rei-okabayashi/denshi-tools/3d/ag03-stand/preview_full_bottom.png

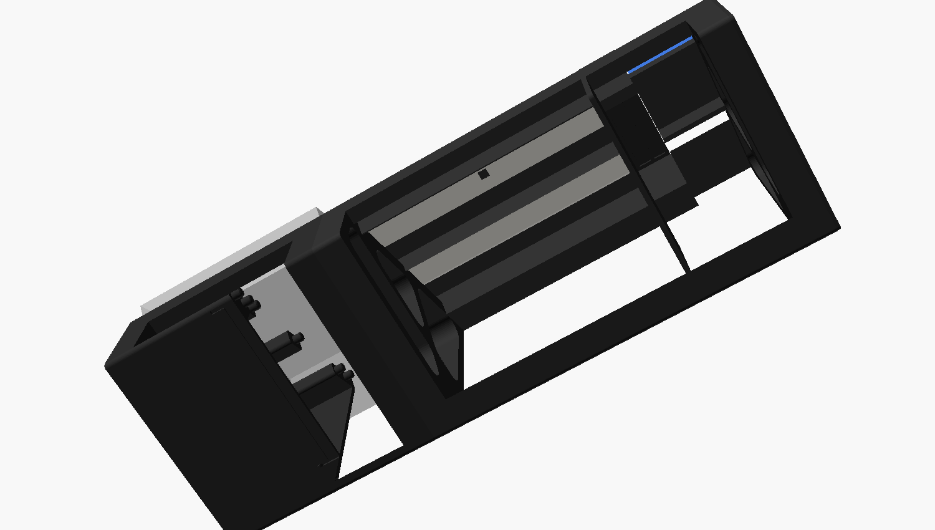
3d/ag03-stand/preview_full_bottom.png
