rei-okabayashi/denshi-tools/3d/ag03-stand/preview_iso.png

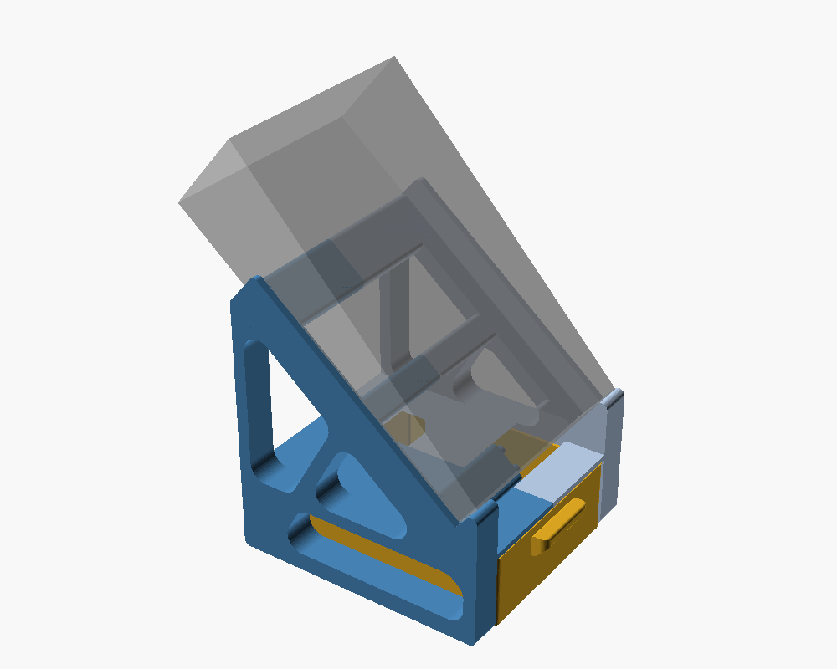
3d/ag03-stand/preview_iso.png
