rei-okabayashi/denshi-tools/3d/ag03-stand/preview_panel_ripple_side.png

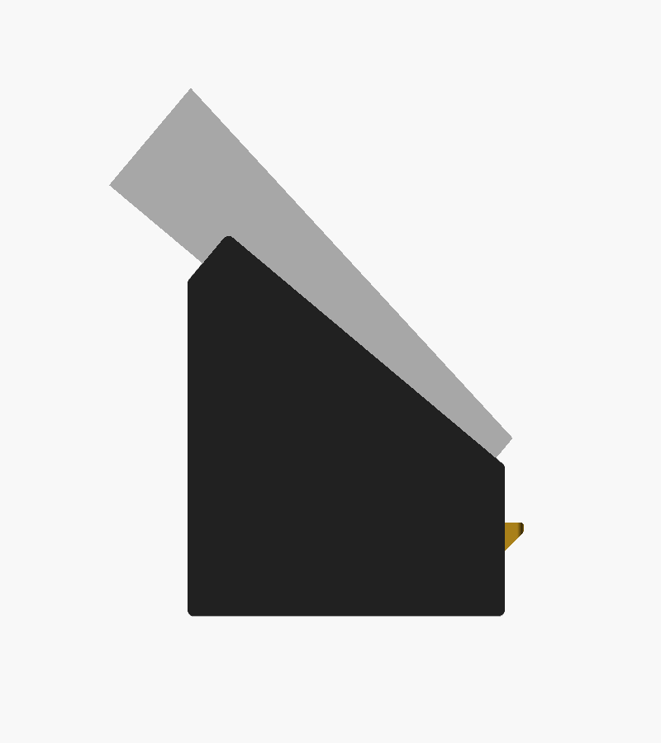
3d/ag03-stand/preview_panel_ripple_side.png
