rei-okabayashi/denshi-tools/3d/ag03-stand/side_panel_concepts.png

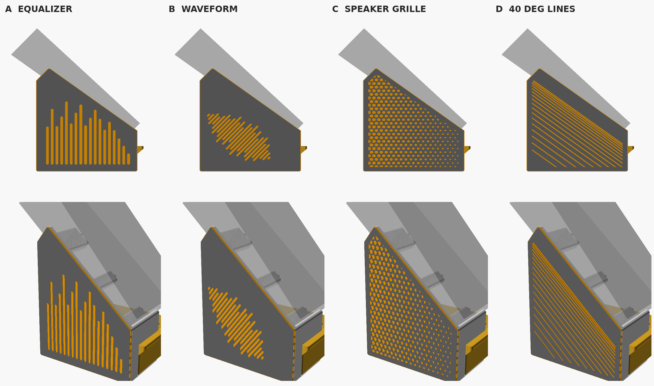
3d/ag03-stand/side_panel_concepts.png
