rei-okabayashi/denshi-tools/3d/ag03-stand/side_panel_concepts_fantasy.png

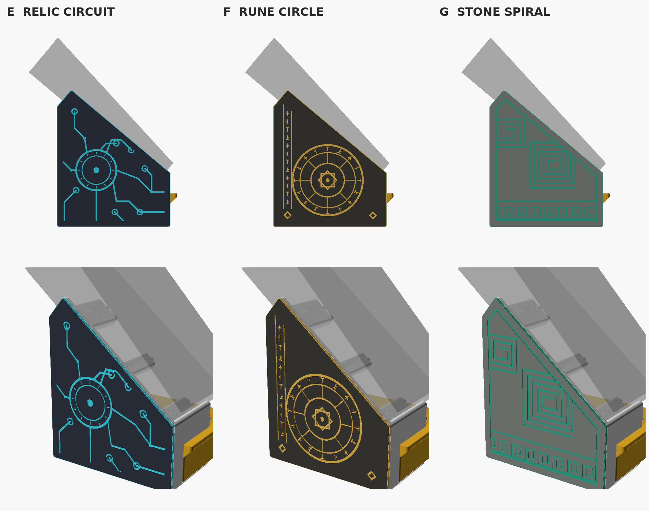
3d/ag03-stand/side_panel_concepts_fantasy.png
