rei-okabayashi/denshi-tools/3d/ag03-stand/ag03_stand_ext_lid.stl

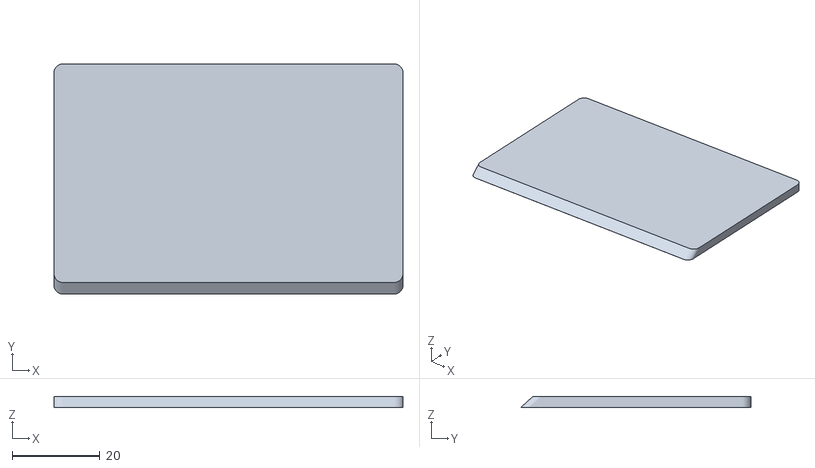
[picture p16: CAD file, 2026-11-06]
3d/ag03-stand/ag03_stand_ext_lid.stl
79.5 x 52.4 x 2.40
