rei-okabayashi/denshi-tools/3d/ag03-stand/viewer/stl/a_ext_p1.stl

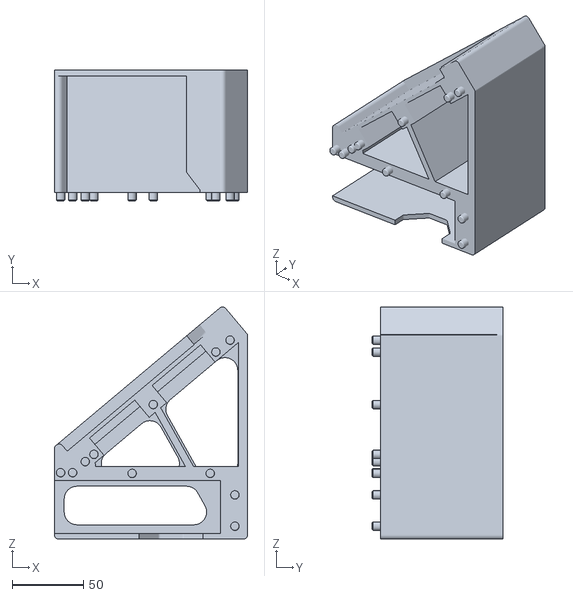
[picture p18: CAD file, 2026-11-06]
3d/ag03-stand/viewer/stl/a_ext_p1.stl
136.1 x 92.0 x 163.2
