rei-okabayashi/denshi-tools/3d/ag03-stand/ag03_stand_half_b.stl

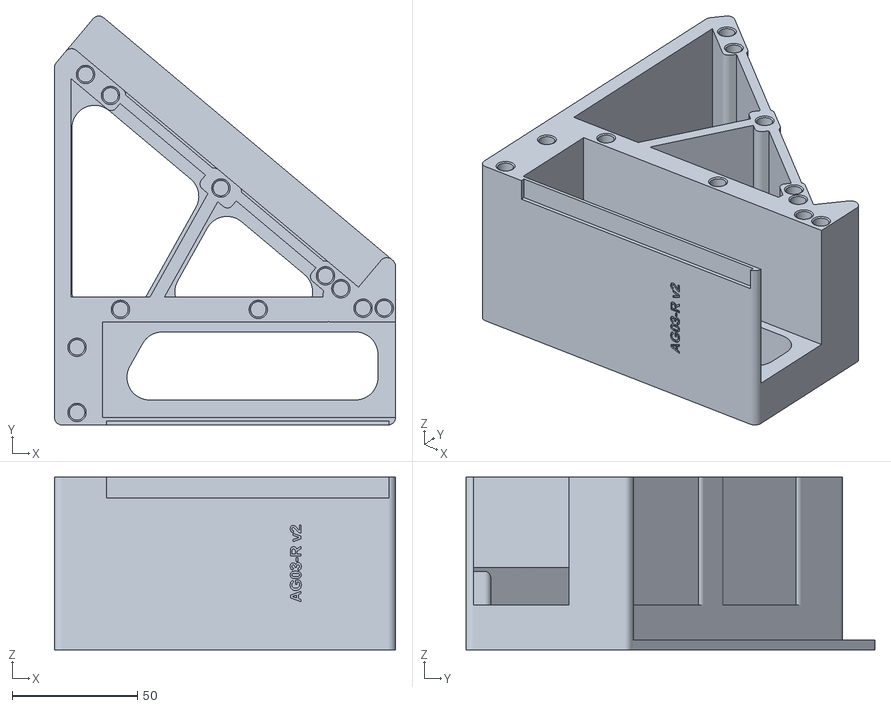
[picture p19: CAD file, 2026-11-06]
3d/ag03-stand/ag03_stand_half_b.stl
136.1 x 163.2 x 69.0
