rei-okabayashi/denshi-tools/3d/ag03-stand/viewer/stl/a_ag_a.stl

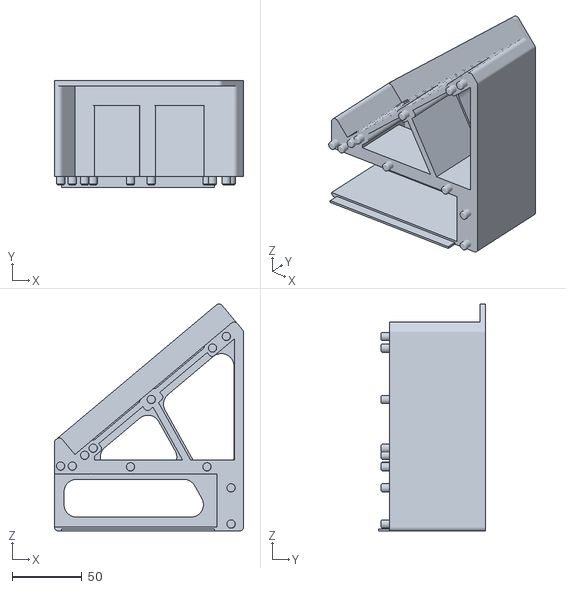
[picture p20: CAD file, 2026-11-06]
3d/ag03-stand/viewer/stl/a_ag_a.stl
136.1 x 77.0 x 163.2
