rei-okabayashi/denshi-tools/3d/ag03-stand/viewer/stl/a_ext_p2.stl

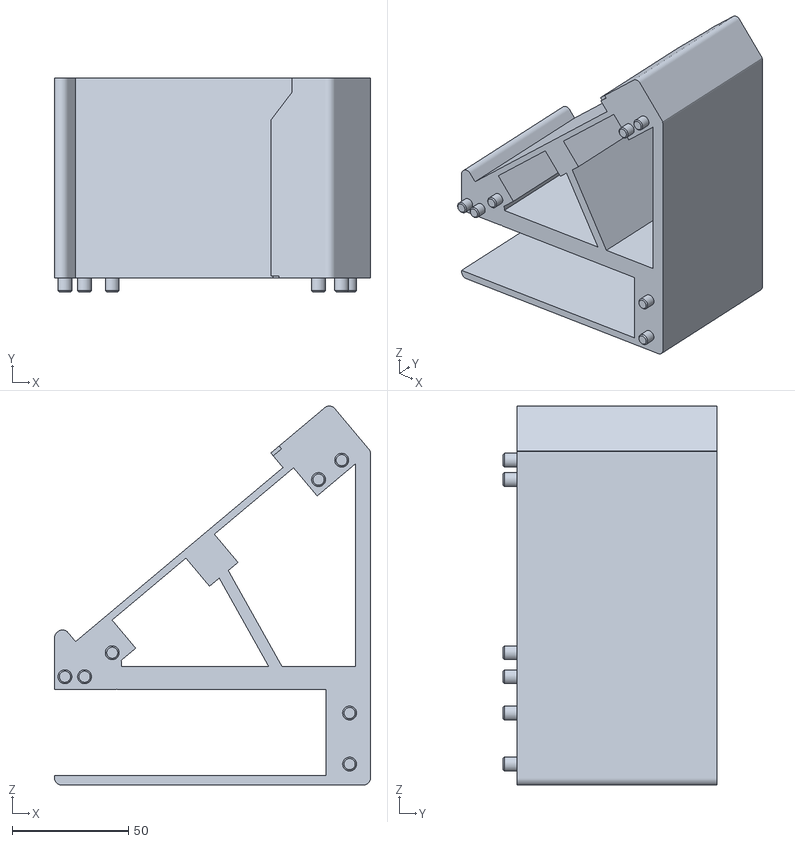
[picture p21: CAD file, 2026-11-06]
3d/ag03-stand/viewer/stl/a_ext_p2.stl
136.1 x 92.2 x 163.2
