rei-okabayashi/denshi-tools/3d/ag03-stand/ag03_stand_drawer.stl

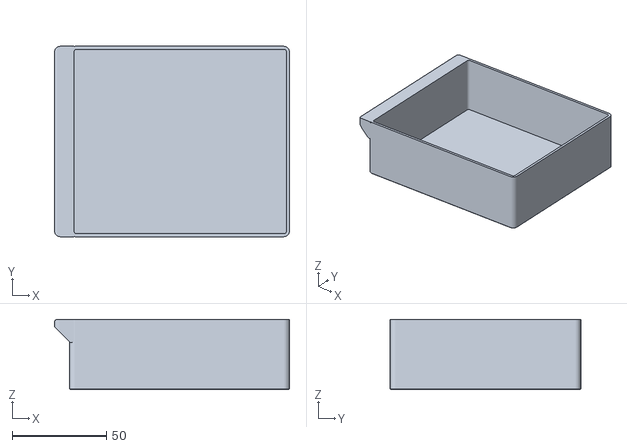
[picture p22: CAD file, 2026-11-06]
3d/ag03-stand/ag03_stand_drawer.stl
124.6 x 101.0 x 37.3
