rei-okabayashi/denshi-tools/3d/ag03-stand/viewer/stl/a_ext_cover.stl

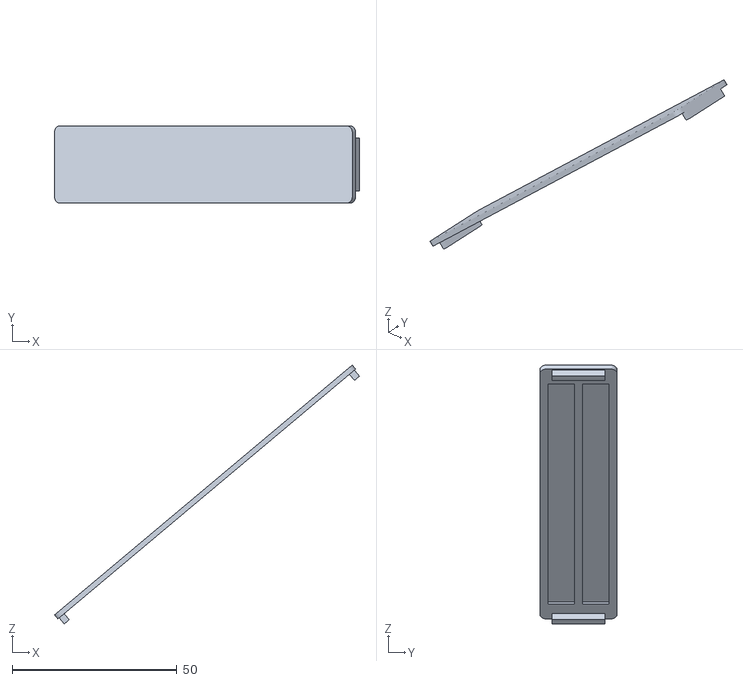
[picture p23: CAD file, 2026-11-06]
3d/ag03-stand/viewer/stl/a_ext_cover.stl
92.6 x 23.4 x 78.6
