rei-okabayashi/denshi-tools/3d/ag03-stand/ag03_stand_ext_p3.stl

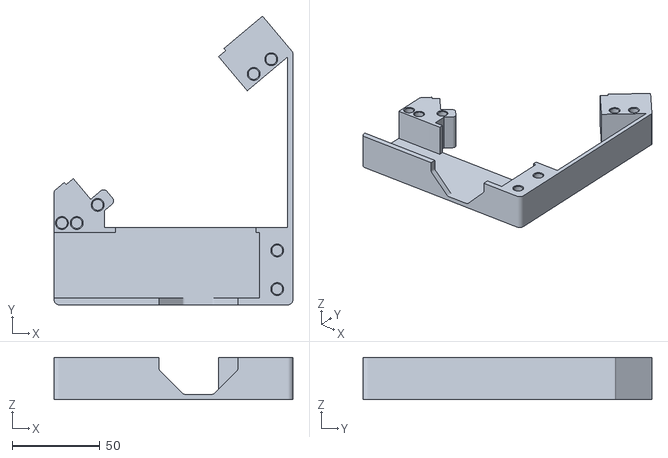
[picture p24: CAD file, 2026-11-05]
3d/ag03-stand/ag03_stand_ext_p3.stl
136.1 x 164.4 x 24.0
