rei-okabayashi/denshi-tools/3d/ag03-stand/ag03_stand_ext_cover.stl

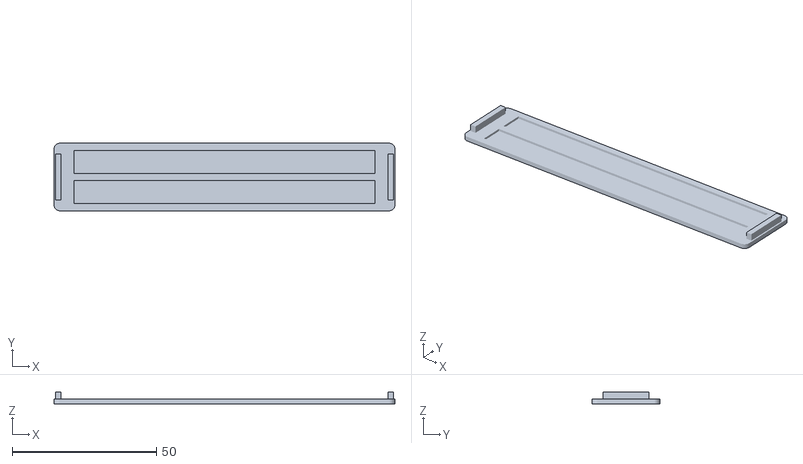
[picture p25: CAD file, 2026-11-05]
3d/ag03-stand/ag03_stand_ext_cover.stl
118.0 x 23.4 x 4.00
