rei-okabayashi/denshi-tools/3d/ag03-stand/viewer/stl/p_ext_p4.stl

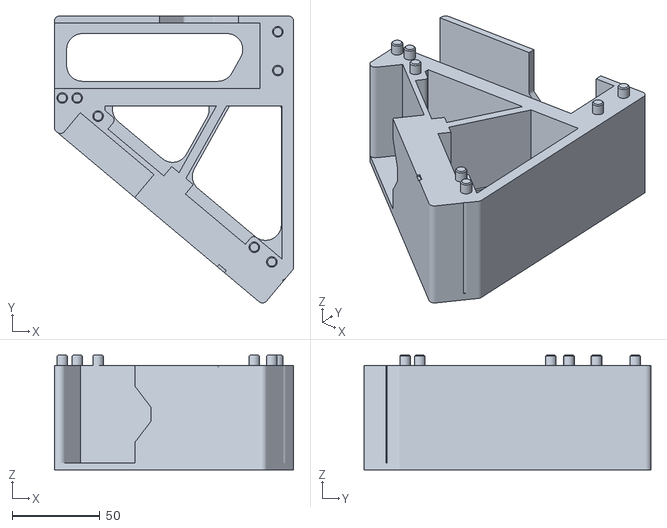
[picture p26: CAD file, 2026-11-06]
3d/ag03-stand/viewer/stl/p_ext_p4.stl
136.1 x 163.2 x 65.3
