rei-okabayashi/denshi-tools/3d/ag03-stand/ag03_stand_panel_a.stl

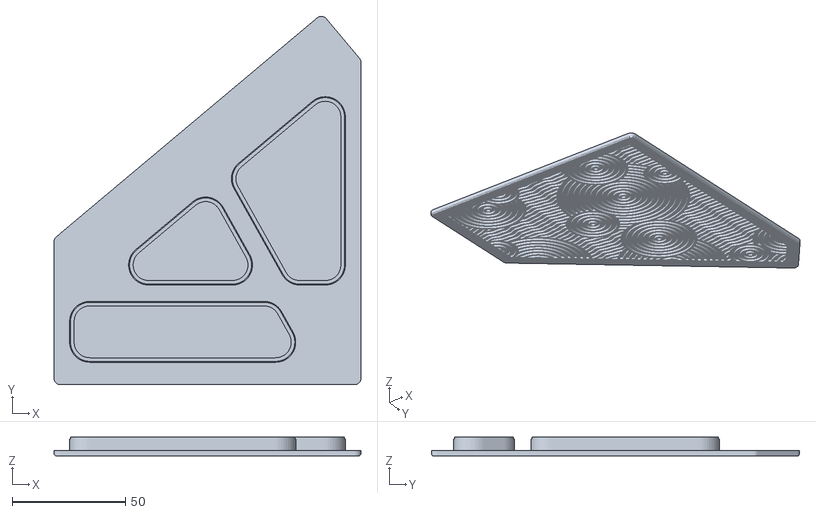
[picture p28: CAD file, 2026-11-04]
3d/ag03-stand/ag03_stand_panel_a.stl
135.7 x 162.8 x 8.39
