rei-okabayashi/denshi-tools/3d/ag03-stand/ag03_stand_fit_test.stl

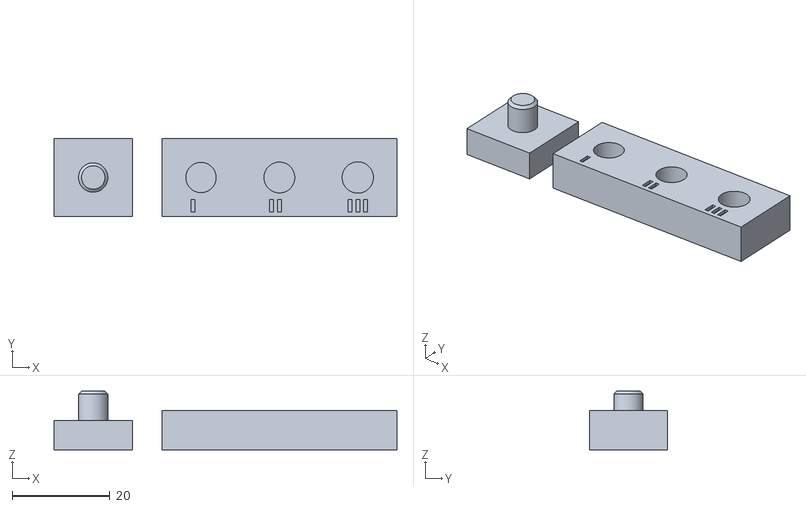
[picture p29: CAD file, 2026-11-03]
3d/ag03-stand/ag03_stand_fit_test.stl
70.0 x 16.0 x 12.0
