rei-okabayashi/denshi-tools/3d/ag03-stand/viewer/stl/a_ext_keys.stl

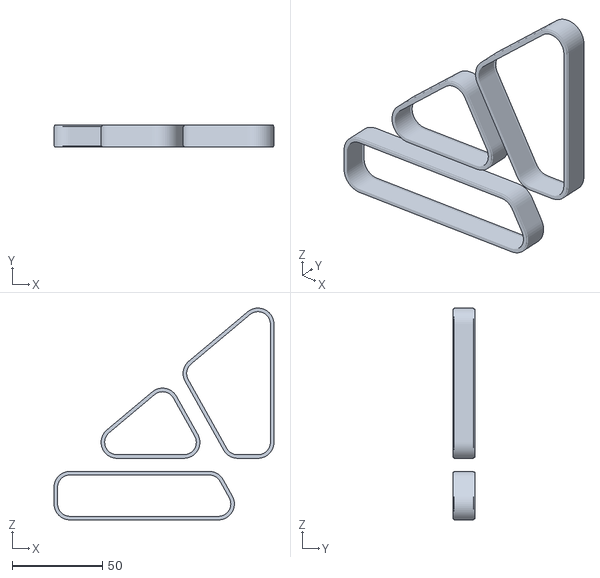
[picture p30: CAD file, 2026-11-05]
3d/ag03-stand/viewer/stl/a_ext_keys.stl
121.9 x 12.0 x 117.4
