rei-okabayashi/denshi-tools/3d/ag03-stand/viewer/stl/a_dev_m5.stl

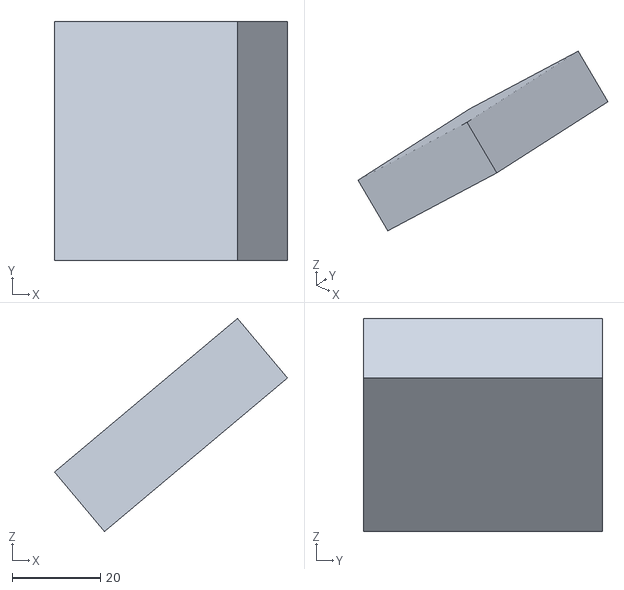
[picture p31: CAD file, 2026-11-05]
3d/ag03-stand/viewer/stl/a_dev_m5.stl
52.8 x 54.1 x 48.3
