rei-okabayashi/denshi-tools/3d/ag03-stand/ripple_pattern.scad

// 自動生成: tools/gen_ripple.py（手で編集しない）
module ripple_pattern2d() {
  polygon(points=[[-8.56,7.90],[-8.56,9.45],[-3.54,6.20],[-5.93,6.20]], paths=[[0, 1, 2, 3]]);
  polygon(points=[[0.00,8.70],[1.77,7.69],[2.63,6.20],[1.75,6.20],[-0.62,7.56],[-8.56,11.83],[-8.56,13.31]], paths=[[0, 1, 2, 3, 4, 5, 6]]);
  polygon(points=[[-3.60,16.21],[-1.81,15.46],[-1.02,15.04],[-0.56,13.31],[-2.34,14.28],[-4.03,14.99],[-8.56,16.47],[-8.56,17.84]], paths=[[0, 1, 2, 3, 4, 5, 6, 7]]);
  polygon(points=[[-5.74,22.65],[-3.64,22.28],[-2.39,21.94],[-1.80,21.73],[-1.77,20.33],[-2.75,20.69],[-3.95,21.01],[-5.90,21.36],[-8.56,21.65],[-8.56,22.95]], paths=[[0, 1, 2, 3, 4, 5, 6, 7, 8, 9]]);
  polygon(points=[[-6.76,27.73],[-4.68,27.46],[-2.68,27.07],[-1.40,26.71],[-1.59,25.42],[-2.96,25.80],[-4.91,26.18],[-6.87,26.43],[-8.56,26.55],[-8.56,27.85]], paths=[[0, 1, 2, 3, 4, 5, 6, 7, 8, 9]]);
  polygon(points=[[-6.72,31.64],[-0.53,30.47],[-0.88,29.21],[-6.91,30.35],[-8.56,30.57],[-8.56,31.88]], paths=[[0, 1, 2, 3, 4, 5]]);
  polygon(points=[[-6.43,34.69],[-1.47,33.84],[0.63,33.66],[0.11,32.37],[-1.67,32.56],[-6.67,33.41],[-8.56,33.84],[-8.56,35.17]], paths=[[0, 1, 2, 3, 4, 5, 6, 7]]);
  polygon(points=[[-3.14,35.37],[-5.39,35.67],[-6.50,35.90],[-5.38,35.93],[-4.13,36.09],[-3.20,36.28],[-2.10,36.61],[-1.05,36.56],[0.63,36.62],[1.96,36.84],[2.29,36.93],[1.47,35.44],[0.72,35.33],[-1.03,35.26]], paths=[[0, 1, 2, 3, 4, 5, 6, 7, 8, 9, 10, 11, 12, 13]]);
  polygon(points=[[12.13,49.51],[13.24,49.98],[14.49,50.39],[16.11,50.76],[19.66,51.21],[23.91,51.41],[22.22,51.12],[20.79,50.80],[18.68,50.19],[16.96,49.56],[16.31,49.48],[14.87,49.14],[13.67,48.75],[12.73,48.35],[11.78,47.84],[10.84,47.18],[10.02,46.48],[8.69,45.03],[7.50,43.50],[6.43,42.43],[5.44,41.35],[4.28,39.91],[3.32,39.23],[2.25,38.66],[1.01,38.20],[2.31,39.23],[3.41,40.36],[4.00,41.09],[4.65,42.07],[4.98,42.39],[7.68,45.85],[9.09,47.39],[10.07,48.23],[11.07,48.92]], paths=[[0, 1, 2, 3, 4, 5, 6, 7, 8, 9, 10, 11, 12, 13, 14, 15, 16, 17, 18, 19, 20, 21, 22, 23, 24, 25, 26, 27, 28, 29, 30, 31, 32, 33]]);
  polygon(points=[[0.81,46.00],[0.51,45.31],[0.14,44.66],[-0.29,44.04],[-0.78,43.47],[-1.77,42.60],[-2.39,42.19],[-3.05,41.83],[-3.75,41.55],[-4.46,41.33],[-5.76,41.12],[-6.51,41.10],[-7.26,41.16],[-8.56,41.43],[-8.56,42.81],[-7.71,42.55],[-6.95,42.43],[-6.01,42.41],[-5.24,42.49],[-4.48,42.67],[-3.61,43.01],[-2.80,43.47],[-2.18,43.94],[-1.72,44.37],[-1.22,44.97],[-0.88,45.48],[-0.52,46.18],[-0.29,46.76],[-0.13,47.36],[-0.00,48.13],[0.03,48.75],[-0.00,49.37],[-0.13,50.14],[-0.29,50.74],[-0.52,51.32],[-0.88,52.01],[-1.22,52.53],[-1.62,53.01],[-2.18,53.56],[-2.93,54.11],[-3.61,54.49],[-4.33,54.78],[-5.24,55.01],[-6.01,55.09],[-6.95,55.07],[-7.71,54.94],[-8.56,54.69],[-8.56,56.06],[-7.63,56.29],[-6.51,56.40],[-5.57,56.36],[-4.46,56.17],[-3.57,55.89],[-2.55,55.40],[-1.62,54.78],[-0.78,54.02],[-0.07,53.15],[0.42,52.35],[0.88,51.33],[1.18,50.24],[1.32,49.12],[1.29,48.00],[1.14,47.07]], paths=[[0, 1, 2, 3, 4, 5, 6, 7, 8, 9, 10, 11, 12, 13, 14, 15, 16, 17, 18, 19, 20, 21, 22, 23, 24, 25, 26, 27, 28, 29, 30, 31, 32, 33, 34, 35, 36, 37, 38, 39, 40, 41, 42, 43, 44, 45, 46, 47, 48, 49, 50, 51, 52, 53, 54, 55, 56, 57, 58, 59, 60, 61, 62]]);
  polygon(points=[[3.52,44.67],[3.19,43.96],[2.67,43.05],[2.23,42.40],[1.57,41.60],[1.02,41.04],[0.23,40.35],[-0.41,39.89],[-1.30,39.36],[-2.01,39.01],[-2.98,38.64],[-3.74,38.42],[-4.76,38.21],[-5.54,38.13],[-6.58,38.10],[-7.63,38.18],[-8.56,38.34],[-8.56,39.67],[-7.47,39.47],[-6.32,39.40],[-5.18,39.47],[-4.05,39.68],[-2.96,40.03],[-1.92,40.50],[-0.94,41.10],[-0.04,41.82],[0.60,42.47],[1.19,43.18],[1.81,44.14],[2.22,44.96],[2.56,45.82],[2.80,46.70],[2.96,47.60],[3.03,48.75],[2.98,49.67],[2.85,50.57],[2.56,51.68],[2.22,52.54],[1.81,53.36],[1.19,54.32],[0.60,55.03],[-0.04,55.68],[-0.94,56.39],[-1.92,56.99],[-2.96,57.47],[-4.05,57.82],[-5.18,58.03],[-6.32,58.10],[-7.47,58.03],[-8.56,57.83],[-8.56,59.16],[-7.11,59.37],[-5.54,59.37],[-4.25,59.19],[-2.74,58.78],[-1.30,58.14],[-0.19,57.46],[1.02,56.46],[1.91,55.50],[2.81,54.22],[3.41,53.06],[3.94,51.59],[4.21,50.31],[4.32,49.01],[4.25,47.44],[3.94,45.91]], paths=[[0, 1, 2, 3, 4, 5, 6, 7, 8, 9, 10, 11, 12, 13, 14, 15, 16, 17, 18, 19, 20, 21, 22, 23, 24, 25, 26, 27, 28, 29, 30, 31, 32, 33, 34, 35, 36, 37, 38, 39, 40, 41, 42, 43, 44, 45, 46, 47, 48, 49, 50, 51, 52, 53, 54, 55, 56, 57, 58, 59, 60, 61, 62, 63, 64, 65]]);
  polygon(points=[[-2.03,46.97],[-2.46,46.17],[-3.12,45.38],[-3.93,44.76],[-4.76,44.37],[-5.75,44.13],[-6.67,44.11],[-7.67,44.30],[-8.56,44.67],[-8.56,46.25],[-8.12,45.92],[-7.60,45.65],[-7.06,45.48],[-6.49,45.40],[-5.91,45.42],[-5.35,45.54],[-4.82,45.76],[-4.33,46.06],[-3.73,46.62],[-3.33,47.24],[-3.05,48.01],[-2.97,48.75],[-3.05,49.48],[-3.33,50.25],[-3.73,50.87],[-4.33,51.44],[-4.82,51.74],[-5.35,51.95],[-5.91,52.07],[-6.49,52.09],[-7.06,52.02],[-7.60,51.84],[-8.12,51.58],[-8.56,51.24],[-8.56,52.83],[-7.89,53.13],[-7.23,53.31],[-6.44,53.40],[-5.75,53.36],[-5.08,53.23],[-4.44,53.00],[-3.84,52.68],[-3.20,52.19],[-2.66,51.61],[-2.28,51.04],[-1.98,50.42],[-1.79,49.77],[-1.68,48.98],[-1.70,48.29],[-1.81,47.62]], paths=[[0, 1, 2, 3, 4, 5, 6, 7, 8, 9, 10, 11, 12, 13, 14, 15, 16, 17, 18, 19, 20, 21, 22, 23, 24, 25, 26, 27, 28, 29, 30, 31, 32, 33, 34, 35, 36, 37, 38, 39, 40, 41, 42, 43, 44, 45, 46, 47, 48, 49]]);
  polygon(points=[[-5.55,48.11],[-5.85,47.87],[-6.22,47.75],[-6.61,47.79],[-6.96,47.98],[-7.20,48.28],[-7.32,48.65],[-7.28,49.04],[-7.10,49.38],[-6.79,49.63],[-6.42,49.74],[-6.03,49.71],[-5.69,49.52],[-5.44,49.22],[-5.33,48.85],[-5.37,48.46]], paths=[[0, 1, 2, 3, 4, 5, 6, 7, 8, 9, 10, 11, 12, 13, 14, 15]]);
  polygon(points=[[25.87,57.09],[24.31,56.64],[22.56,56.31],[20.71,56.11],[18.42,56.05],[15.67,56.15],[12.60,56.44],[9.82,56.84],[7.57,57.27],[5.48,57.81],[0.85,59.41],[0.01,59.93],[-1.12,60.50],[-1.99,60.85],[-3.20,61.21],[-4.13,61.41],[-5.38,61.56],[-6.95,61.58],[-8.56,61.40],[-8.55,61.55],[-8.48,61.83],[-8.34,62.08],[-7.76,62.59],[-6.46,62.47],[-3.14,61.95],[-0.34,61.20],[5.88,59.04],[7.83,58.54],[10.05,58.12],[12.77,57.73],[15.74,57.45],[18.45,57.35],[20.65,57.41],[22.35,57.59],[24.04,57.91],[25.48,58.33],[26.90,58.92],[28.32,59.74],[29.51,60.68],[30.47,61.63],[33.00,64.43],[33.81,65.16],[34.67,65.78],[35.75,66.33],[37.00,66.72],[38.38,66.86],[39.11,66.81],[38.23,66.62],[37.21,66.26],[36.23,65.79],[35.32,65.20],[34.65,64.64],[34.04,64.03],[33.36,63.18],[32.79,62.27],[31.43,60.75],[30.34,59.68],[29.01,58.64],[27.52,57.77]], paths=[[0, 1, 2, 3, 4, 5, 6, 7, 8, 9, 10, 11, 12, 13, 14, 15, 16, 17, 18, 19, 20, 21, 22, 23, 24, 25, 26, 27, 28, 29, 30, 31, 32, 33, 34, 35, 36, 37, 38, 39, 40, 41, 42, 43, 44, 45, 46, 47, 48, 49, 50, 51, 52, 53, 54, 55, 56, 57, 58]]);
  polygon(points=[[24.67,60.57],[26.09,61.36],[27.03,62.05],[28.01,62.92],[31.97,67.17],[32.90,67.95],[33.93,68.61],[34.93,69.06],[36.03,69.35],[37.39,69.47],[38.85,69.34],[40.44,68.94],[41.94,68.32],[43.61,67.31],[44.94,66.20],[45.91,65.16],[45.14,65.68],[44.18,66.18],[42.95,66.62],[41.88,66.84],[41.40,67.14],[39.99,67.72],[38.59,68.07],[37.44,68.17],[36.30,68.08],[35.41,67.85],[34.50,67.45],[33.70,66.93],[32.89,66.25],[28.90,61.96],[27.87,61.05],[26.83,60.29],[25.26,59.41],[23.60,58.77],[21.85,58.35],[19.96,58.11],[17.96,58.06],[15.86,58.18],[13.61,58.48],[11.31,58.95],[7.72,60.01],[0.74,62.60],[-0.97,63.09],[-2.42,63.41],[-5.13,63.79],[-6.22,63.88],[-4.81,65.06],[-2.17,64.69],[-0.63,64.35],[1.12,63.84],[8.15,61.23],[11.60,60.22],[13.80,59.77],[16.00,59.47],[17.95,59.36],[19.89,59.41],[21.57,59.62],[23.25,60.03]], paths=[[0, 1, 2, 3, 4, 5, 6, 7, 8, 9, 10, 11, 12, 13, 14, 15, 16, 17, 18, 19, 20, 21, 22, 23, 24, 25, 26, 27, 28, 29, 30, 31, 32, 33, 34, 35, 36, 37, 38, 39, 40, 41, 42, 43, 44, 45, 46, 47, 48, 49, 50, 51, 52, 53, 54, 55, 56, 57]]);
  polygon(points=[[8.09,63.28],[8.84,62.83],[10.01,62.22],[11.21,61.70],[12.46,61.27],[13.73,60.94],[14.59,60.77],[15.89,60.59],[17.20,60.51],[18.51,60.53],[19.82,60.64],[20.69,60.77],[21.97,61.04],[22.82,61.27],[24.06,61.70],[25.27,62.22],[26.23,62.71],[25.86,62.40],[24.46,61.51],[22.87,60.79],[21.12,60.30],[19.21,60.03],[17.39,60.00],[15.32,60.18],[13.27,60.56],[11.27,61.12],[9.47,61.76],[7.66,62.54],[1.18,65.72],[-0.51,66.36],[-1.95,66.76],[-2.64,66.89],[-1.37,67.95],[-0.08,67.59],[1.73,66.90],[6.06,64.78],[7.00,64.02]], paths=[[0, 1, 2, 3, 4, 5, 6, 7, 8, 9, 10, 11, 12, 13, 14, 15, 16, 17, 18, 19, 20, 21, 22, 23, 24, 25, 26, 27, 28, 29, 30, 31, 32, 33, 34, 35, 36]]);
  polygon(points=[[2.33,69.18],[3.07,68.05],[2.34,68.55],[0.60,69.60],[1.63,70.46]], paths=[[0, 1, 2, 3, 4]]);
  polygon(points=[[29.32,73.52],[28.94,72.67],[28.49,71.85],[27.98,71.07],[27.42,70.33],[26.80,69.63],[26.13,68.98],[25.42,68.38],[24.67,67.84],[23.87,67.35],[23.05,66.92],[22.19,66.55],[21.31,66.25],[20.41,66.01],[19.19,65.80],[18.26,65.72],[17.33,65.71],[16.40,65.77],[15.47,65.89],[14.56,66.09],[13.67,66.34],[12.80,66.67],[11.95,67.06],[11.13,67.51],[10.35,68.01],[9.61,68.58],[8.91,69.19],[8.26,69.86],[7.67,70.57],[7.12,71.33],[6.63,72.12],[6.20,72.95],[5.78,73.95],[6.85,74.84],[7.38,73.50],[8.05,72.28],[8.52,71.60],[9.04,70.94],[10.02,69.95],[11.10,69.08],[11.80,68.62],[12.53,68.22],[13.81,67.67],[15.15,67.28],[16.53,67.06],[17.92,67.01],[19.30,67.13],[20.40,67.35],[21.72,67.77],[22.74,68.22],[23.94,68.92],[24.84,69.58],[25.66,70.33],[26.59,71.37],[27.37,72.52],[28.01,73.76],[28.50,75.06],[28.82,76.42],[28.96,77.52],[28.97,78.91],[28.82,80.30],[28.50,81.65],[28.23,82.44],[27.90,83.21],[27.23,84.43],[26.41,85.56],[25.86,86.18],[25.26,86.77],[24.17,87.64],[22.97,88.37],[24.04,89.27],[24.92,88.70],[25.90,87.93],[26.80,87.08],[27.42,86.38],[27.98,85.64],[28.64,84.59],[29.20,83.48],[29.65,82.32],[29.91,81.43],[30.15,80.21],[30.25,79.29],[30.28,78.05],[30.19,76.81],[29.98,75.58],[29.65,74.39]], paths=[[0, 1, 2, 3, 4, 5, 6, 7, 8, 9, 10, 11, 12, 13, 14, 15, 16, 17, 18, 19, 20, 21, 22, 23, 24, 25, 26, 27, 28, 29, 30, 31, 32, 33, 34, 35, 36, 37, 38, 39, 40, 41, 42, 43, 44, 45, 46, 47, 48, 49, 50, 51, 52, 53, 54, 55, 56, 57, 58, 59, 60, 61, 62, 63, 64, 65, 66, 67, 68, 69, 70, 71, 72, 73, 74, 75, 76, 77, 78, 79, 80, 81, 82, 83, 84, 85]]);
  polygon(points=[[26.55,74.66],[25.91,73.40],[25.39,72.61],[24.94,72.05],[24.29,71.37],[23.76,70.90],[22.60,70.08],[21.98,69.74],[21.11,69.35],[19.75,68.94],[18.35,68.73],[16.93,68.73],[15.52,68.94],[14.61,69.19],[13.94,69.44],[13.09,69.85],[12.47,70.20],[11.33,71.05],[10.65,71.70],[10.18,72.23],[9.36,73.40],[8.72,74.66],[8.27,76.04],[9.40,76.99],[9.65,75.93],[10.09,74.79],[10.69,73.72],[11.45,72.75],[12.34,71.90],[13.34,71.19],[14.44,70.64],[15.41,70.31],[16.41,70.10],[17.43,70.01],[18.46,70.05],[19.47,70.21],[20.45,70.49],[21.21,70.81],[22.10,71.30],[22.93,71.90],[23.69,72.60],[24.34,73.38],[24.90,74.24],[25.35,75.16],[25.69,76.13],[25.90,77.13],[25.99,78.15],[25.95,79.17],[25.74,80.39],[25.35,81.55],[24.90,82.47],[24.22,83.49],[23.40,84.40],[22.45,85.18],[21.39,85.81],[20.42,86.23],[21.55,87.18],[22.19,86.87],[23.00,86.38],[23.76,85.82],[24.46,85.18],[25.10,84.48],[25.66,83.72],[26.15,82.91],[26.55,82.05],[26.87,81.16],[27.10,80.24],[27.24,79.30],[27.29,78.36],[27.24,77.41],[27.10,76.47],[26.87,75.56]], paths=[[0, 1, 2, 3, 4, 5, 6, 7, 8, 9, 10, 11, 12, 13, 14, 15, 16, 17, 18, 19, 20, 21, 22, 23, 24, 25, 26, 27, 28, 29, 30, 31, 32, 33, 34, 35, 36, 37, 38, 39, 40, 41, 42, 43, 44, 45, 46, 47, 48, 49, 50, 51, 52, 53, 54, 55, 56, 57, 58, 59, 60, 61, 62, 63, 64, 65, 66, 67, 68, 69, 70, 71]]);
  polygon(points=[[23.84,75.96],[23.34,74.94],[22.67,74.01],[21.86,73.22],[20.92,72.57],[19.88,72.09],[18.77,71.80],[17.64,71.71],[16.50,71.80],[15.40,72.09],[14.36,72.57],[13.42,73.22],[12.60,74.01],[11.93,74.94],[11.43,75.96],[11.12,77.06],[11.02,77.70],[10.99,78.32],[12.41,79.52],[12.29,78.49],[12.35,77.57],[12.56,76.68],[12.92,75.83],[13.42,75.06],[14.04,74.39],[14.78,73.84],[15.59,73.41],[16.21,73.20],[16.98,73.05],[17.77,73.01],[18.42,73.06],[19.06,73.20],[19.81,73.47],[20.39,73.77],[21.03,74.22],[21.51,74.67],[22.01,75.28],[22.36,75.83],[22.67,76.55],[22.86,77.18],[22.97,77.96],[22.97,78.75],[22.88,79.40],[22.63,80.28],[22.23,81.11],[21.60,81.95],[20.93,82.57],[20.16,83.07],[19.32,83.44],[18.42,83.65],[17.40,83.70],[18.83,84.90],[19.57,84.72],[20.18,84.50],[20.92,84.14],[21.47,83.79],[22.10,83.28],[22.56,82.82],[22.98,82.32],[23.42,81.63],[23.78,80.90],[24.00,80.29],[24.16,79.65],[24.27,78.85],[24.28,78.03],[24.22,77.38],[24.05,76.58]], paths=[[0, 1, 2, 3, 4, 5, 6, 7, 8, 9, 10, 11, 12, 13, 14, 15, 16, 17, 18, 19, 20, 21, 22, 23, 24, 25, 26, 27, 28, 29, 30, 31, 32, 33, 34, 35, 36, 37, 38, 39, 40, 41, 42, 43, 44, 45, 46, 47, 48, 49, 50, 51, 52, 53, 54, 55, 56, 57, 58, 59, 60, 61, 62, 63, 64, 65, 66]]);
  polygon(points=[[21.01,76.96],[20.67,76.33],[20.22,75.78],[19.67,75.32],[19.03,74.98],[18.35,74.78],[17.64,74.71],[16.93,74.78],[16.24,74.98],[15.61,75.32],[15.06,75.78],[14.60,76.33],[14.27,76.96],[14.06,77.64],[13.99,78.36],[14.06,79.07],[14.27,79.75],[14.60,80.38],[15.06,80.94],[15.61,81.39],[16.24,81.73],[16.93,81.94],[17.64,82.01],[18.35,81.94],[19.03,81.73],[19.67,81.39],[20.22,80.94],[20.67,80.38],[21.01,79.75],[21.22,79.07],[21.29,78.36],[21.22,77.64],[19.81,79.26],[19.59,79.66],[19.30,80.02],[18.94,80.31],[18.54,80.53],[18.10,80.66],[17.64,80.71],[17.18,80.66],[16.74,80.53],[16.33,80.31],[15.98,80.02],[15.68,79.66],[15.47,79.26],[15.33,78.81],[15.29,78.36],[15.33,77.90],[15.47,77.46],[15.68,77.05],[15.98,76.69],[16.33,76.40],[16.74,76.19],[17.18,76.05],[17.64,76.01],[18.10,76.05],[18.54,76.19],[18.94,76.40],[19.30,76.69],[19.59,77.05],[19.81,77.46],[19.94,77.90],[19.99,78.36],[19.94,78.81]], paths=[[0, 1, 2, 3, 4, 5, 6, 7, 8, 9, 10, 11, 12, 13, 14, 15, 16, 17, 18, 19, 20, 21, 22, 23, 24, 25, 26, 27, 28, 29, 30, 31], [32, 33, 34, 35, 36, 37, 38, 39, 40, 41, 42, 43, 44, 45, 46, 47, 48, 49, 50, 51, 52, 53, 54, 55, 56, 57, 58, 59, 60, 61, 62, 63]]);
  polygon(points=[[18.38,77.68],[18.07,77.45],[17.69,77.36],[17.30,77.41],[16.97,77.62],[16.73,77.93],[16.64,78.31],[16.70,78.69],[16.90,79.03],[17.21,79.26],[17.59,79.36],[17.97,79.30],[18.31,79.10],[18.54,78.78],[18.64,78.41],[18.58,78.02]], paths=[[0, 1, 2, 3, 4, 5, 6, 7, 8, 9, 10, 11, 12, 13, 14, 15]]);
  polygon(points=[[42.16,102.91],[42.52,102.73],[43.64,101.25],[44.38,100.45],[45.03,99.84],[43.13,100.95],[41.68,101.70],[40.03,102.30],[39.64,102.36],[40.86,103.38]], paths=[[0, 1, 2, 3, 4, 5, 6, 7, 8, 9]]);
  polygon(points=[[37.05,18.37],[36.66,17.51],[36.20,16.69],[35.65,15.91],[35.03,15.19],[34.35,14.54],[33.60,13.96],[32.80,13.45],[31.96,13.03],[31.07,12.68],[30.16,12.43],[29.23,12.27],[28.28,12.20],[27.34,12.22],[26.40,12.34],[25.47,12.55],[24.57,12.84],[23.71,13.23],[22.88,13.70],[22.11,14.24],[21.39,14.86],[20.74,15.54],[20.16,16.29],[19.65,17.09],[19.22,17.94],[18.88,18.82],[18.63,19.73],[18.47,20.67],[18.40,21.61],[18.42,22.56],[18.54,23.50],[18.74,24.42],[19.04,25.32],[19.43,26.19],[19.89,27.01],[20.44,27.78],[21.06,28.50],[21.74,29.15],[22.49,29.74],[23.29,30.24],[24.13,30.67],[25.02,31.01],[25.93,31.26],[26.86,31.43],[27.81,31.49],[28.75,31.47],[29.69,31.36],[30.62,31.15],[31.52,30.85],[32.38,30.47],[33.21,30.00],[33.98,29.46],[34.70,28.84],[35.35,28.15],[35.93,27.40],[36.44,26.60],[36.87,25.76],[37.21,24.87],[37.46,23.96],[37.62,23.03],[37.69,22.08],[37.67,21.14],[37.55,20.20],[37.35,19.27],[35.84,24.85],[35.50,25.60],[35.10,26.32],[34.63,26.99],[34.09,27.61],[33.50,28.17],[32.85,28.67],[32.16,29.11],[31.43,29.48],[30.66,29.78],[29.87,29.99],[29.07,30.14],[28.25,30.20],[27.43,30.18],[26.62,30.07],[25.82,29.90],[25.04,29.64],[24.29,29.31],[23.58,28.90],[22.91,28.43],[22.29,27.90],[21.72,27.30],[21.22,26.66],[20.78,25.96],[20.41,25.23],[20.12,24.47],[19.90,23.68],[19.76,22.87],[19.70,22.05],[19.72,21.23],[19.82,20.42],[20.00,19.62],[20.25,18.84],[20.59,18.09],[20.99,17.38],[21.46,16.71],[22.00,16.09],[22.59,15.53],[23.24,15.02],[23.93,14.58],[24.66,14.21],[25.43,13.92],[26.22,13.70],[27.02,13.56],[27.84,13.50],[28.66,13.52],[29.47,13.62],[30.27,13.80],[31.05,14.06],[31.80,14.39],[32.51,14.79],[33.18,15.27],[33.80,15.80],[34.37,16.39],[34.87,17.04],[35.31,17.73],[35.68,18.46],[35.97,19.23],[36.19,20.02],[36.33,20.83],[36.39,21.64],[36.37,22.46],[36.27,23.28],[36.09,24.07]], paths=[[0, 1, 2, 3, 4, 5, 6, 7, 8, 9, 10, 11, 12, 13, 14, 15, 16, 17, 18, 19, 20, 21, 22, 23, 24, 25, 26, 27, 28, 29, 30, 31, 32, 33, 34, 35, 36, 37, 38, 39, 40, 41, 42, 43, 44, 45, 46, 47, 48, 49, 50, 51, 52, 53, 54, 55, 56, 57, 58, 59, 60, 61, 62, 63], [64, 65, 66, 67, 68, 69, 70, 71, 72, 73, 74, 75, 76, 77, 78, 79, 80, 81, 82, 83, 84, 85, 86, 87, 88, 89, 90, 91, 92, 93, 94, 95, 96, 97, 98, 99, 100, 101, 102, 103, 104, 105, 106, 107, 108, 109, 110, 111, 112, 113, 114, 115, 116, 117, 118, 119, 120, 121, 122, 123, 124, 125, 126, 127]]);
  polygon(points=[[39.73,17.01],[39.20,15.88],[38.56,14.82],[37.82,13.82],[36.99,12.90],[36.07,12.07],[35.07,11.33],[34.01,10.69],[32.89,10.16],[31.72,9.74],[30.51,9.44],[29.28,9.26],[28.05,9.20],[26.81,9.26],[25.58,9.44],[24.37,9.74],[23.20,10.16],[22.08,10.69],[21.02,11.33],[20.02,12.07],[19.10,12.90],[18.27,13.82],[17.53,14.82],[16.89,15.88],[16.36,17.01],[15.94,18.18],[15.64,19.38],[15.46,20.61],[15.40,21.85],[15.46,23.09],[15.64,24.32],[15.94,25.52],[16.36,26.69],[16.89,27.81],[17.53,28.88],[18.27,29.87],[19.10,30.79],[20.02,31.63],[21.02,32.37],[22.08,33.00],[23.20,33.53],[24.37,33.95],[25.58,34.25],[26.81,34.44],[28.05,34.50],[29.28,34.44],[30.51,34.25],[31.72,33.95],[32.89,33.53],[34.01,33.00],[35.07,32.37],[36.07,31.63],[36.99,30.79],[37.82,29.87],[38.56,28.88],[39.20,27.81],[39.73,26.69],[40.15,25.52],[40.45,24.32],[40.63,23.09],[40.70,21.85],[40.63,20.61],[40.45,19.38],[40.15,18.18],[38.53,26.19],[38.05,27.20],[37.48,28.15],[36.82,29.05],[36.07,29.87],[35.25,30.62],[34.35,31.29],[33.40,31.86],[32.39,32.33],[31.34,32.71],[30.26,32.98],[29.16,33.14],[28.05,33.20],[26.93,33.14],[25.83,32.98],[24.75,32.71],[23.70,32.33],[22.69,31.86],[21.74,31.29],[20.84,30.62],[20.02,29.87],[19.27,29.05],[18.61,28.15],[18.04,27.20],[17.56,26.19],[17.18,25.14],[16.91,24.06],[16.75,22.96],[16.70,21.85],[16.75,20.74],[16.91,19.63],[17.18,18.55],[17.56,17.50],[18.04,16.50],[18.61,15.54],[19.27,14.65],[20.02,13.82],[20.84,13.07],[21.74,12.41],[22.69,11.84],[23.70,11.36],[24.75,10.99],[25.83,10.72],[26.93,10.55],[28.05,10.50],[29.16,10.55],[30.26,10.72],[31.34,10.99],[32.39,11.36],[33.40,11.84],[34.35,12.41],[35.25,13.07],[36.07,13.82],[36.82,14.65],[37.48,15.54],[38.05,16.50],[38.53,17.50],[38.91,18.55],[39.18,19.63],[39.34,20.74],[39.40,21.85],[39.34,22.96],[39.18,24.06],[38.91,25.14]], paths=[[0, 1, 2, 3, 4, 5, 6, 7, 8, 9, 10, 11, 12, 13, 14, 15, 16, 17, 18, 19, 20, 21, 22, 23, 24, 25, 26, 27, 28, 29, 30, 31, 32, 33, 34, 35, 36, 37, 38, 39, 40, 41, 42, 43, 44, 45, 46, 47, 48, 49, 50, 51, 52, 53, 54, 55, 56, 57, 58, 59, 60, 61, 62, 63], [64, 65, 66, 67, 68, 69, 70, 71, 72, 73, 74, 75, 76, 77, 78, 79, 80, 81, 82, 83, 84, 85, 86, 87, 88, 89, 90, 91, 92, 93, 94, 95, 96, 97, 98, 99, 100, 101, 102, 103, 104, 105, 106, 107, 108, 109, 110, 111, 112, 113, 114, 115, 116, 117, 118, 119, 120, 121, 122, 123, 124, 125, 126, 127]]);
  polygon(points=[[42.50,15.86],[41.85,14.47],[41.06,13.15],[40.14,11.92],[39.11,10.78],[37.97,9.75],[36.74,8.84],[35.42,8.05],[34.03,7.39],[32.59,6.87],[31.10,6.50],[29.58,6.27],[28.22,6.20],[26.51,6.27],[24.99,6.50],[23.50,6.87],[22.06,7.39],[20.67,8.05],[19.35,8.84],[18.12,9.75],[16.98,10.78],[15.95,11.92],[15.03,13.15],[14.24,14.47],[13.59,15.86],[13.07,17.30],[12.70,18.79],[12.47,20.31],[12.40,21.85],[12.47,23.38],[12.70,24.90],[13.07,26.39],[13.59,27.84],[14.24,29.23],[15.03,30.54],[15.95,31.78],[16.98,32.91],[18.12,33.95],[19.35,34.86],[20.67,35.65],[22.06,36.31],[23.50,36.82],[24.99,37.20],[26.51,37.42],[28.05,37.50],[29.58,37.42],[31.10,37.20],[32.59,36.82],[34.03,36.31],[35.42,35.65],[36.74,34.86],[37.97,33.95],[39.11,32.91],[40.14,31.78],[41.06,30.54],[41.85,29.23],[42.50,27.84],[43.02,26.39],[43.39,24.90],[43.62,23.38],[43.70,21.85],[43.62,20.31],[43.39,18.79],[43.02,17.30],[41.30,27.34],[40.70,28.61],[39.98,29.82],[39.14,30.95],[38.19,31.99],[37.15,32.94],[36.02,33.78],[34.81,34.50],[33.54,35.11],[32.21,35.58],[30.84,35.92],[29.45,36.13],[28.05,36.20],[26.64,36.13],[25.25,35.92],[23.88,35.58],[22.55,35.11],[21.28,34.50],[20.07,33.78],[18.94,32.94],[17.90,31.99],[16.95,30.95],[16.11,29.82],[15.39,28.61],[14.79,27.34],[14.31,26.01],[13.97,24.65],[13.76,23.25],[13.70,21.85],[13.76,20.44],[13.97,19.05],[14.31,17.68],[14.79,16.36],[15.39,15.08],[16.11,13.88],[16.95,12.74],[17.90,11.70],[18.94,10.76],[20.07,9.92],[21.28,9.19],[22.55,8.59],[23.88,8.12],[25.25,7.77],[26.64,7.57],[28.05,7.50],[29.45,7.57],[30.84,7.77],[32.21,8.12],[33.54,8.59],[34.81,9.19],[36.02,9.92],[37.15,10.76],[38.19,11.70],[39.14,12.74],[39.98,13.88],[40.70,15.08],[41.30,16.36],[41.78,17.68],[42.12,19.05],[42.33,20.44],[42.40,21.85],[42.33,23.25],[42.12,24.65],[41.78,26.01]], paths=[[0, 1, 2, 3, 4, 5, 6, 7, 8, 9, 10, 11, 12, 13, 14, 15, 16, 17, 18, 19, 20, 21, 22, 23, 24, 25, 26, 27, 28, 29, 30, 31, 32, 33, 34, 35, 36, 37, 38, 39, 40, 41, 42, 43, 44, 45, 46, 47, 48, 49, 50, 51, 52, 53, 54, 55, 56, 57, 58, 59, 60, 61, 62, 63], [64, 65, 66, 67, 68, 69, 70, 71, 72, 73, 74, 75, 76, 77, 78, 79, 80, 81, 82, 83, 84, 85, 86, 87, 88, 89, 90, 91, 92, 93, 94, 95, 96, 97, 98, 99, 100, 101, 102, 103, 104, 105, 106, 107, 108, 109, 110, 111, 112, 113, 114, 115, 116, 117, 118, 119, 120, 121, 122, 123, 124, 125, 126, 127]]);
  polygon(points=[[34.25,19.45],[33.99,18.86],[33.66,18.29],[33.29,17.76],[32.86,17.26],[32.39,16.81],[31.87,16.41],[31.32,16.06],[30.74,15.77],[30.13,15.53],[29.50,15.36],[28.86,15.25],[28.21,15.20],[27.56,15.22],[26.91,15.30],[26.27,15.44],[25.65,15.64],[25.06,15.91],[24.49,16.23],[23.95,16.61],[23.46,17.03],[23.01,17.50],[22.61,18.02],[22.26,18.57],[21.97,19.15],[21.73,19.76],[21.56,20.39],[21.45,21.03],[21.40,21.68],[21.41,22.34],[21.49,22.98],[21.64,23.62],[21.84,24.24],[22.11,24.84],[22.43,25.41],[22.80,25.94],[23.23,26.43],[23.70,26.88],[24.22,27.28],[24.77,27.63],[25.35,27.93],[25.96,28.16],[26.59,28.34],[27.23,28.45],[27.88,28.50],[28.53,28.48],[29.18,28.40],[29.82,28.26],[30.44,28.05],[31.03,27.79],[31.60,27.47],[32.14,27.09],[32.63,26.66],[33.08,26.19],[33.48,25.68],[33.83,25.13],[34.12,24.54],[34.36,23.93],[34.53,23.30],[34.65,22.66],[34.69,22.01],[34.68,21.36],[34.60,20.71],[34.45,20.07],[33.04,23.77],[32.57,24.71],[31.92,25.54],[31.13,26.22],[30.21,26.74],[29.22,27.07],[28.18,27.20],[27.13,27.12],[26.12,26.84],[25.18,26.37],[24.36,25.72],[23.67,24.93],[23.15,24.02],[22.83,23.02],[22.70,21.98],[22.77,20.93],[23.05,19.92],[23.53,18.99],[24.17,18.16],[24.96,17.47],[25.88,16.96],[26.87,16.63],[27.91,16.50],[28.96,16.58],[29.97,16.86],[30.91,17.33],[31.73,17.97],[32.42,18.77],[32.94,19.68],[33.27,20.68],[33.39,21.72],[33.32,22.76]], paths=[[0, 1, 2, 3, 4, 5, 6, 7, 8, 9, 10, 11, 12, 13, 14, 15, 16, 17, 18, 19, 20, 21, 22, 23, 24, 25, 26, 27, 28, 29, 30, 31, 32, 33, 34, 35, 36, 37, 38, 39, 40, 41, 42, 43, 44, 45, 46, 47, 48, 49, 50, 51, 52, 53, 54, 55, 56, 57, 58, 59, 60, 61, 62, 63], [64, 65, 66, 67, 68, 69, 70, 71, 72, 73, 74, 75, 76, 77, 78, 79, 80, 81, 82, 83, 84, 85, 86, 87, 88, 89, 90, 91, 92, 93, 94, 95]]);
  polygon(points=[[28.79,21.18],[28.47,20.94],[28.09,20.85],[27.71,20.91],[27.37,21.11],[27.14,21.42],[27.05,21.80],[27.10,22.18],[27.30,22.52],[27.62,22.75],[28.00,22.85],[28.38,22.79],[28.72,22.59],[28.95,22.28],[29.04,21.90],[28.99,21.51]], paths=[[0, 1, 2, 3, 4, 5, 6, 7, 8, 9, 10, 11, 12, 13, 14, 15]]);
  polygon(points=[[31.42,20.45],[31.08,19.82],[30.63,19.27],[30.07,18.81],[29.44,18.48],[28.76,18.27],[28.05,18.20],[27.33,18.27],[26.65,18.48],[26.02,18.81],[25.46,19.27],[25.01,19.82],[24.67,20.45],[24.47,21.14],[24.40,21.85],[24.47,22.56],[24.67,23.24],[25.01,23.88],[25.46,24.43],[26.02,24.88],[26.65,25.22],[27.33,25.43],[28.05,25.50],[28.76,25.43],[29.44,25.22],[30.07,24.88],[30.63,24.43],[31.08,23.88],[31.42,23.24],[31.62,22.56],[31.70,21.85],[31.62,21.14],[30.22,22.75],[30.00,23.15],[29.71,23.51],[29.35,23.80],[28.94,24.02],[28.50,24.15],[28.05,24.20],[27.59,24.15],[27.15,24.02],[26.74,23.80],[26.38,23.51],[26.09,23.15],[25.87,22.75],[25.74,22.31],[25.70,21.85],[25.74,21.39],[25.87,20.95],[26.09,20.54],[26.38,20.19],[26.74,19.89],[27.15,19.68],[27.59,19.54],[28.05,19.50],[28.50,19.54],[28.94,19.68],[29.35,19.89],[29.71,20.19],[30.00,20.54],[30.22,20.95],[30.35,21.39],[30.40,21.85],[30.35,22.31]], paths=[[0, 1, 2, 3, 4, 5, 6, 7, 8, 9, 10, 11, 12, 13, 14, 15, 16, 17, 18, 19, 20, 21, 22, 23, 24, 25, 26, 27, 28, 29, 30, 31], [32, 33, 34, 35, 36, 37, 38, 39, 40, 41, 42, 43, 44, 45, 46, 47, 48, 49, 50, 51, 52, 53, 54, 55, 56, 57, 58, 59, 60, 61, 62, 63]]);
  polygon(points=[[45.45,15.14],[44.90,13.87],[44.49,13.06],[44.04,12.26],[43.29,11.11],[42.46,10.02],[41.86,9.32],[40.57,8.03],[39.52,7.15],[38.19,6.20],[35.54,6.20],[36.96,6.97],[38.38,7.91],[39.70,8.99],[40.90,10.20],[41.98,11.51],[42.93,12.93],[43.54,14.05],[44.23,15.60],[44.77,17.22],[45.14,18.88],[45.35,20.57],[45.39,22.27],[45.26,23.97],[45.06,25.23],[44.65,26.88],[44.07,28.49],[43.54,29.65],[42.70,31.13],[41.72,32.52],[40.61,33.81],[39.70,34.70],[38.38,35.78],[36.96,36.73],[35.46,37.53],[33.89,38.18],[32.67,38.57],[31.01,38.94],[29.32,39.15],[27.62,39.19],[25.92,39.07],[24.24,38.78],[22.60,38.32],[21.41,37.88],[20.24,37.35],[19.13,36.73],[18.41,36.27],[17.37,35.53],[16.39,34.70],[15.48,33.81],[14.63,32.85],[13.86,31.84],[13.16,30.77],[12.74,30.03],[12.18,28.88],[11.71,27.69],[11.44,26.88],[11.12,25.65],[10.88,24.39],[10.74,23.12],[10.70,21.42],[10.78,20.15],[10.95,18.88],[11.22,17.63],[11.57,16.41],[12.02,15.21],[12.74,13.67],[13.62,12.21],[14.37,11.17],[15.19,10.20],[16.08,9.28],[17.04,8.44],[18.05,7.66],[19.13,6.97],[20.55,6.20],[17.90,6.20],[16.57,7.15],[15.52,8.03],[14.23,9.32],[13.34,10.37],[12.54,11.49],[11.60,13.06],[11.00,14.29],[10.34,16.00],[9.95,17.32],[9.60,19.11],[9.45,20.48],[9.40,22.31],[9.54,24.13],[9.75,25.49],[10.07,26.82],[10.64,28.56],[11.39,30.23],[12.29,31.83],[13.34,33.32],[14.54,34.71],[15.86,35.97],[17.31,37.10],[18.85,38.07],[20.49,38.90],[22.19,39.56],[23.96,40.04],[25.76,40.36],[27.59,40.49],[29.42,40.45],[31.23,40.22],[33.02,39.82],[34.76,39.25],[36.43,38.51],[38.02,37.60],[39.52,36.55],[40.91,35.36],[42.17,34.03],[43.29,32.59],[44.27,31.04],[45.10,29.41],[45.75,27.70],[46.24,25.93],[46.55,24.13],[46.69,22.31],[46.64,20.48],[46.42,18.66],[46.02,16.87]], paths=[[0, 1, 2, 3, 4, 5, 6, 7, 8, 9, 10, 11, 12, 13, 14, 15, 16, 17, 18, 19, 20, 21, 22, 23, 24, 25, 26, 27, 28, 29, 30, 31, 32, 33, 34, 35, 36, 37, 38, 39, 40, 41, 42, 43, 44, 45, 46, 47, 48, 49, 50, 51, 52, 53, 54, 55, 56, 57, 58, 59, 60, 61, 62, 63, 64, 65, 66, 67, 68, 69, 70, 71, 72, 73, 74, 75, 76, 77, 78, 79, 80, 81, 82, 83, 84, 85, 86, 87, 88, 89, 90, 91, 92, 93, 94, 95, 96, 97, 98, 99, 100, 101, 102, 103, 104, 105, 106, 107, 108, 109, 110, 111, 112, 113, 114, 115, 116, 117, 118, 119, 120, 121, 122]]);
  polygon(points=[[48.05,13.56],[47.38,12.11],[46.34,10.27],[45.11,8.53],[43.73,6.92],[43.01,6.20],[41.05,6.20],[42.08,7.11],[43.12,8.18],[44.09,9.33],[44.68,10.13],[45.24,10.96],[45.99,12.25],[46.65,13.60],[47.03,14.52],[47.37,15.46],[47.79,16.90],[48.10,18.37],[48.30,19.85],[48.37,20.85],[48.39,22.35],[48.30,23.84],[48.17,24.83],[47.90,26.31],[47.66,27.28],[47.37,28.23],[46.85,29.64],[46.22,31.00],[45.50,32.31],[44.68,33.57],[44.09,34.37],[43.12,35.51],[42.08,36.59],[41.34,37.26],[40.17,38.19],[39.35,38.77],[38.08,39.55],[37.19,40.02],[35.83,40.65],[34.43,41.17],[32.50,41.70],[30.54,42.04],[28.54,42.19],[27.05,42.17],[25.06,41.98],[23.59,41.70],[21.66,41.17],[20.26,40.65],[18.45,39.79],[16.74,38.77],[15.14,37.58],[13.66,36.24],[12.64,35.14],[11.70,33.97],[10.59,32.31],[9.65,30.55],[9.06,29.17],[8.43,27.28],[7.99,25.33],[7.79,23.84],[7.70,21.85],[7.79,19.85],[7.99,18.37],[8.30,16.90],[8.88,14.99],[9.44,13.60],[10.34,11.82],[11.12,10.54],[12.31,8.94],[13.66,7.46],[15.04,6.20],[13.08,6.20],[12.00,7.31],[11.31,8.11],[10.04,9.82],[8.95,11.64],[8.04,13.56],[7.33,15.56],[6.81,17.62],[6.56,19.20],[6.40,21.32],[6.42,22.91],[6.63,25.02],[6.92,26.59],[7.49,28.64],[8.04,30.13],[8.95,32.05],[10.04,33.88],[11.31,35.58],[12.74,37.16],[14.31,38.58],[16.02,39.85],[17.84,40.94],[19.76,41.85],[21.76,42.57],[23.82,43.08],[25.92,43.39],[28.05,43.50],[30.17,43.39],[32.27,43.08],[34.33,42.57],[36.33,41.85],[38.25,40.94],[40.07,39.85],[41.78,38.58],[43.35,37.16],[44.78,35.58],[46.05,33.88],[47.14,32.05],[48.05,30.13],[48.76,28.13],[49.28,26.07],[49.59,23.97],[49.70,21.85],[49.59,19.73],[49.28,17.62],[48.76,15.56]], paths=[[0, 1, 2, 3, 4, 5, 6, 7, 8, 9, 10, 11, 12, 13, 14, 15, 16, 17, 18, 19, 20, 21, 22, 23, 24, 25, 26, 27, 28, 29, 30, 31, 32, 33, 34, 35, 36, 37, 38, 39, 40, 41, 42, 43, 44, 45, 46, 47, 48, 49, 50, 51, 52, 53, 54, 55, 56, 57, 58, 59, 60, 61, 62, 63, 64, 65, 66, 67, 68, 69, 70, 71, 72, 73, 74, 75, 76, 77, 78, 79, 80, 81, 82, 83, 84, 85, 86, 87, 88, 89, 90, 91, 92, 93, 94, 95, 96, 97, 98, 99, 100, 101, 102, 103, 104, 105, 106, 107, 108, 109, 110, 111, 112, 113, 114, 115, 116]]);
  polygon(points=[[53.59,11.27],[53.04,10.03],[52.43,8.81],[51.76,7.63],[50.84,6.20],[49.24,6.20],[50.31,7.75],[51.28,9.43],[52.13,11.17],[52.63,12.36],[53.07,13.58],[53.61,15.45],[54.01,17.34],[54.27,19.27],[54.39,21.20],[54.39,22.49],[54.27,24.43],[54.11,25.71],[53.75,27.62],[53.44,28.88],[52.85,30.72],[52.13,32.53],[51.58,33.70],[50.97,34.84],[50.31,35.95],[49.59,37.02],[48.82,38.06],[48.00,39.06],[46.68,40.48],[45.74,41.37],[44.76,42.22],[43.74,43.01],[42.68,43.76],[41.59,44.45],[40.47,45.09],[39.31,45.67],[38.13,46.19],[36.31,46.87],[34.45,47.41],[32.55,47.81],[31.27,48.00],[29.98,48.13],[28.05,48.20],[26.75,48.17],[25.46,48.07],[24.18,47.91],[22.90,47.69],[21.02,47.24],[19.17,46.66],[17.37,45.94],[16.20,45.38],[15.06,44.77],[13.41,43.76],[11.83,42.62],[10.35,41.37],[8.96,40.02],[8.09,39.06],[7.27,38.06],[6.14,36.49],[5.12,34.84],[4.22,33.11],[3.70,31.93],[3.24,30.72],[2.65,28.88],[2.34,27.62],[2.08,26.35],[1.82,24.43],[1.70,22.49],[1.73,20.55],[1.82,19.27],[1.98,17.98],[2.34,16.07],[2.83,14.20],[3.24,12.97],[3.70,11.76],[4.51,10.00],[5.44,8.30],[6.14,7.21],[6.85,6.20],[5.25,6.20],[3.99,8.22],[3.35,9.42],[2.77,10.64],[2.01,12.53],[1.59,13.82],[1.22,15.13],[0.80,17.12],[0.60,18.46],[0.43,20.49],[0.40,22.53],[0.53,24.56],[0.80,26.57],[1.22,28.57],[1.79,30.52],[2.50,32.43],[3.05,33.67],[3.66,34.88],[4.33,36.06],[5.05,37.21],[5.84,38.32],[6.67,39.39],[7.56,40.42],[8.49,41.40],[9.48,42.34],[10.50,43.22],[11.57,44.06],[12.68,44.84],[13.83,45.56],[15.01,46.23],[16.22,46.84],[17.46,47.39],[18.73,47.88],[20.02,48.31],[21.33,48.67],[22.65,48.97],[23.99,49.20],[25.33,49.36],[26.69,49.46],[28.05,49.50],[29.40,49.46],[30.76,49.36],[32.10,49.20],[33.44,48.97],[34.76,48.67],[36.07,48.31],[37.36,47.88],[38.63,47.39],[39.87,46.84],[41.08,46.23],[42.26,45.56],[43.41,44.84],[44.52,44.06],[45.59,43.22],[46.61,42.34],[47.60,41.40],[48.53,40.42],[49.42,39.39],[50.25,38.32],[51.04,37.21],[51.76,36.06],[52.43,34.88],[53.04,33.67],[53.59,32.43],[54.08,31.16],[54.50,29.87],[54.87,28.57],[55.16,27.24],[55.40,25.90],[55.56,24.56],[55.66,23.20],[55.70,21.85],[55.66,20.49],[55.56,19.14],[55.40,17.79],[55.16,16.45],[54.87,15.13],[54.50,13.82],[54.08,12.53]], paths=[[0, 1, 2, 3, 4, 5, 6, 7, 8, 9, 10, 11, 12, 13, 14, 15, 16, 17, 18, 19, 20, 21, 22, 23, 24, 25, 26, 27, 28, 29, 30, 31, 32, 33, 34, 35, 36, 37, 38, 39, 40, 41, 42, 43, 44, 45, 46, 47, 48, 49, 50, 51, 52, 53, 54, 55, 56, 57, 58, 59, 60, 61, 62, 63, 64, 65, 66, 67, 68, 69, 70, 71, 72, 73, 74, 75, 76, 77, 78, 79, 80, 81, 82, 83, 84, 85, 86, 87, 88, 89, 90, 91, 92, 93, 94, 95, 96, 97, 98, 99, 100, 101, 102, 103, 104, 105, 106, 107, 108, 109, 110, 111, 112, 113, 114, 115, 116, 117, 118, 119, 120, 121, 122, 123, 124, 125, 126, 127, 128, 129, 130, 131, 132, 133, 134, 135, 136, 137, 138, 139, 140, 141, 142, 143, 144, 145, 146, 147, 148, 149, 150, 151, 152, 153, 154, 155, 156, 157]]);
  polygon(points=[[51.04,12.98],[50.06,10.76],[49.19,9.18],[48.20,7.65],[47.10,6.21],[45.38,6.20],[46.45,7.48],[47.14,8.40],[47.77,9.36],[48.64,10.84],[49.39,12.39],[49.83,13.44],[50.39,15.07],[50.70,16.17],[50.95,17.29],[51.22,18.99],[51.33,20.13],[51.40,21.85],[51.33,23.57],[51.22,24.71],[51.05,25.84],[50.70,27.52],[50.03,29.71],[49.39,31.31],[48.90,32.35],[48.07,33.85],[47.46,34.82],[46.45,36.21],[45.73,37.10],[44.56,38.36],[43.73,39.15],[42.86,39.90],[41.49,40.94],[40.54,41.58],[39.05,42.44],[38.03,42.96],[36.45,43.63],[34.82,44.19],[32.60,44.75],[30.90,45.02],[28.62,45.19],[26.90,45.17],[25.19,45.02],[22.93,44.63],[21.27,44.19],[19.64,43.63],[18.06,42.96],[16.04,41.88],[14.60,40.94],[13.23,39.90],[11.53,38.36],[10.36,37.10],[8.95,35.29],[7.73,33.36],[6.94,31.83],[6.26,30.25],[5.54,28.08],[5.04,25.84],[4.81,24.14],[4.70,22.42],[4.72,20.70],[4.95,18.42],[5.26,16.73],[5.70,15.07],[6.47,12.91],[7.19,11.35],[8.32,9.36],[9.29,7.94],[10.71,6.20],[9.00,6.20],[8.25,7.16],[7.55,8.15],[6.31,10.23],[5.51,11.86],[4.64,14.12],[3.99,16.45],[3.66,18.23],[3.46,20.03],[3.40,21.85],[3.46,23.66],[3.66,25.46],[3.99,27.25],[4.46,29.00],[5.05,30.72],[6.03,32.93],[7.22,35.04],[8.61,37.01],[10.19,38.85],[11.94,40.51],[13.85,42.00],[15.90,43.30],[18.06,44.38],[20.31,45.25],[22.64,45.90],[25.03,46.31],[27.44,46.49],[29.86,46.43],[32.26,46.13],[34.62,45.60],[36.92,44.85],[39.13,43.87],[41.23,42.67],[43.21,41.28],[45.04,39.70],[46.71,37.95],[48.20,36.04],[49.49,34.00],[50.58,31.84],[51.45,29.58],[52.10,27.25],[52.51,24.87],[52.69,22.45],[52.63,20.03],[52.33,17.63],[51.80,15.27]], paths=[[0, 1, 2, 3, 4, 5, 6, 7, 8, 9, 10, 11, 12, 13, 14, 15, 16, 17, 18, 19, 20, 21, 22, 23, 24, 25, 26, 27, 28, 29, 30, 31, 32, 33, 34, 35, 36, 37, 38, 39, 40, 41, 42, 43, 44, 45, 46, 47, 48, 49, 50, 51, 52, 53, 54, 55, 56, 57, 58, 59, 60, 61, 62, 63, 64, 65, 66, 67, 68, 69, 70, 71, 72, 73, 74, 75, 76, 77, 78, 79, 80, 81, 82, 83, 84, 85, 86, 87, 88, 89, 90, 91, 92, 93, 94, 95, 96, 97, 98, 99, 100, 101, 102, 103, 104, 105, 106, 107, 108, 109, 110, 111, 112, 113, 114]]);
  polygon(points=[[55.44,40.97],[56.82,39.94],[56.47,38.54],[54.68,39.92],[50.24,42.90],[48.54,43.88],[47.76,44.26],[45.83,45.82],[43.97,47.10],[45.68,46.57],[47.43,45.87],[49.13,45.03],[50.94,43.99]], paths=[[0, 1, 2, 3, 4, 5, 6, 7, 8, 9, 10, 11, 12]]);
  polygon(points=[[57.67,43.19],[58.35,42.98],[57.63,41.84],[57.18,41.99],[55.88,42.56],[49.15,46.29],[47.44,47.08],[46.10,47.58],[43.81,48.15],[41.46,48.51],[39.83,49.27],[40.59,49.24],[41.46,49.28],[42.32,49.41],[43.04,49.58],[44.10,49.42],[46.51,48.81],[47.97,48.27],[49.72,47.46],[56.48,43.72]], paths=[[0, 1, 2, 3, 4, 5, 6, 7, 8, 9, 10, 11, 12, 13, 14, 15, 16, 17, 18, 19]]);
  polygon(points=[[58.13,45.88],[59.54,45.56],[60.46,45.48],[60.89,45.49],[60.06,44.84],[59.44,44.26],[57.80,44.62],[55.91,45.33],[53.91,46.30],[49.41,48.71],[46.98,49.73],[46.05,49.99],[44.64,50.22],[45.51,50.73],[46.25,51.28],[47.37,50.97],[50.00,49.87],[54.49,47.46],[56.45,46.51]], paths=[[0, 1, 2, 3, 4, 5, 6, 7, 8, 9, 10, 11, 12, 13, 14, 15, 16, 17, 18]]);
  polygon(points=[[35.74,50.69],[33.15,51.26],[31.61,51.48],[32.53,51.43],[34.83,51.11],[35.27,51.02]], paths=[[0, 1, 2, 3, 4, 5]]);
  polygon(points=[[15.16,52.99],[24.14,53.46],[30.63,54.09],[32.43,54.14],[32.68,54.12],[33.12,53.35],[33.59,52.67],[32.42,52.84],[30.73,52.80],[24.23,52.17],[15.26,51.69],[12.63,51.31],[10.39,50.73],[9.21,50.27],[8.02,49.66],[7.09,49.04],[6.52,48.55],[6.45,50.17],[7.40,50.80],[8.71,51.47],[10.03,51.97],[12.41,52.59]], paths=[[0, 1, 2, 3, 4, 5, 6, 7, 8, 9, 10, 11, 12, 13, 14, 15, 16, 17, 18, 19, 20, 21]]);
  polygon(points=[[31.33,57.78],[31.74,58.04],[31.87,56.59],[29.96,55.75],[27.58,54.98],[25.02,54.45],[22.47,54.15],[18.95,54.00],[8.20,53.95],[5.65,54.10],[5.33,54.16],[4.86,55.08],[4.46,55.74],[4.87,55.59],[5.78,55.39],[8.21,55.25],[18.93,55.30],[22.39,55.45],[24.84,55.73],[27.28,56.25],[29.46,56.95]], paths=[[0, 1, 2, 3, 4, 5, 6, 7, 8, 9, 10, 11, 12, 13, 14, 15, 16, 17, 18, 19, 20]]);
  polygon(points=[[41.33,57.42],[41.02,57.18],[40.64,57.09],[40.26,57.15],[39.92,57.35],[39.69,57.66],[39.59,58.04],[39.65,58.42],[39.85,58.76],[40.16,58.99],[40.54,59.09],[40.93,59.03],[41.26,58.83],[41.50,58.51],[41.59,58.14],[41.53,57.75]], paths=[[0, 1, 2, 3, 4, 5, 6, 7, 8, 9, 10, 11, 12, 13, 14, 15]]);
  polygon(points=[[46.67,55.39],[46.38,54.81],[46.03,54.26],[45.63,53.74],[45.18,53.27],[44.68,52.84],[44.15,52.47],[43.58,52.15],[42.99,51.88],[42.37,51.68],[41.73,51.53],[41.08,51.45],[40.43,51.44],[39.78,51.49],[39.14,51.60],[38.51,51.77],[37.90,52.01],[37.31,52.30],[36.76,52.65],[36.25,53.05],[35.78,53.50],[35.35,54.00],[34.97,54.53],[34.65,55.10],[34.39,55.69],[34.18,56.31],[34.04,56.95],[33.96,57.60],[33.94,58.25],[33.99,58.90],[34.10,59.54],[34.28,60.17],[34.51,60.78],[34.81,61.36],[35.16,61.92],[35.56,62.43],[36.01,62.90],[36.50,63.33],[37.03,63.71],[37.60,64.03],[38.20,64.29],[38.82,64.50],[39.46,64.64],[40.10,64.72],[40.76,64.73],[41.41,64.69],[42.05,64.58],[42.68,64.40],[43.29,64.17],[43.87,63.87],[44.42,63.52],[44.94,63.12],[45.41,62.67],[45.83,62.18],[46.21,61.64],[46.53,61.08],[46.80,60.48],[47.00,59.86],[47.14,59.22],[47.22,58.58],[47.24,57.92],[47.19,57.27],[47.08,56.63],[46.91,56.00],[45.48,60.25],[44.97,61.17],[44.28,61.96],[43.45,62.61],[42.52,63.08],[41.51,63.36],[40.46,63.44],[39.42,63.31],[38.42,62.98],[37.51,62.46],[36.72,61.78],[36.07,60.95],[35.60,60.01],[35.32,59.00],[35.24,57.96],[35.37,56.91],[35.70,55.92],[36.22,55.01],[36.90,54.21],[37.73,53.57],[38.67,53.10],[39.68,52.82],[40.72,52.74],[41.76,52.87],[42.76,53.20],[43.67,53.71],[44.47,54.40],[45.11,55.22],[45.58,56.16],[45.86,57.17],[45.94,58.22],[45.81,59.26]], paths=[[0, 1, 2, 3, 4, 5, 6, 7, 8, 9, 10, 11, 12, 13, 14, 15, 16, 17, 18, 19, 20, 21, 22, 23, 24, 25, 26, 27, 28, 29, 30, 31, 32, 33, 34, 35, 36, 37, 38, 39, 40, 41, 42, 43, 44, 45, 46, 47, 48, 49, 50, 51, 52, 53, 54, 55, 56, 57, 58, 59, 60, 61, 62, 63], [64, 65, 66, 67, 68, 69, 70, 71, 72, 73, 74, 75, 76, 77, 78, 79, 80, 81, 82, 83, 84, 85, 86, 87, 88, 89, 90, 91, 92, 93, 94, 95]]);
  polygon(points=[[43.96,56.69],[43.63,56.06],[43.17,55.51],[42.62,55.05],[41.99,54.71],[41.30,54.51],[40.59,54.44],[39.88,54.51],[39.20,54.71],[38.56,55.05],[38.01,55.51],[37.56,56.06],[37.22,56.69],[37.01,57.37],[36.94,58.09],[37.01,58.80],[37.22,59.48],[37.56,60.11],[38.01,60.67],[38.56,61.12],[39.20,61.46],[39.88,61.67],[40.59,61.74],[41.30,61.67],[41.99,61.46],[42.62,61.12],[43.17,60.67],[43.63,60.11],[43.96,59.48],[44.17,58.80],[44.24,58.09],[44.17,57.37],[42.76,58.99],[42.55,59.39],[42.25,59.75],[41.90,60.04],[41.49,60.26],[41.05,60.39],[40.59,60.44],[40.13,60.39],[39.69,60.26],[39.29,60.04],[38.93,59.75],[38.64,59.39],[38.42,58.99],[38.29,58.55],[38.24,58.09],[38.29,57.63],[38.42,57.19],[38.64,56.78],[38.93,56.43],[39.29,56.13],[39.69,55.92],[40.13,55.78],[40.59,55.74],[41.05,55.78],[41.49,55.92],[41.90,56.13],[42.25,56.43],[42.55,56.78],[42.76,57.19],[42.90,57.63],[42.94,58.09],[42.90,58.55]], paths=[[0, 1, 2, 3, 4, 5, 6, 7, 8, 9, 10, 11, 12, 13, 14, 15, 16, 17, 18, 19, 20, 21, 22, 23, 24, 25, 26, 27, 28, 29, 30, 31], [32, 33, 34, 35, 36, 37, 38, 39, 40, 41, 42, 43, 44, 45, 46, 47, 48, 49, 50, 51, 52, 53, 54, 55, 56, 57, 58, 59, 60, 61, 62, 63]]);
  polygon(points=[[42.03,71.10],[43.78,70.03],[44.76,69.24],[45.10,67.95],[45.53,66.68],[44.50,67.77],[43.07,68.95],[41.39,69.97],[39.72,70.71],[37.81,71.25],[36.66,71.40],[35.52,71.37],[34.41,71.11],[33.82,70.82],[34.49,72.46],[35.43,72.67],[36.78,72.69],[38.12,72.51],[40.20,71.91]], paths=[[0, 1, 2, 3, 4, 5, 6, 7, 8, 9, 10, 11, 12, 13, 14, 15, 16, 17, 18]]);
  polygon(points=[[44.25,73.41],[44.34,71.80],[42.87,72.76],[40.69,73.82],[38.00,74.82],[35.56,75.47],[35.26,75.51],[35.42,76.80],[35.86,76.73],[38.36,76.07],[41.17,75.03],[43.55,73.87]], paths=[[0, 1, 2, 3, 4, 5, 6, 7, 8, 9, 10, 11]]);
  polygon(points=[[32.24,72.72],[31.79,71.67],[31.25,70.64],[30.65,69.66],[29.98,68.73],[29.23,67.85],[28.43,67.02],[27.57,66.26],[26.65,65.56],[25.68,64.93],[24.67,64.38],[23.63,63.90],[22.55,63.50],[21.44,63.18],[20.31,62.94],[19.17,62.78],[18.02,62.71],[16.87,62.73],[15.72,62.82],[14.58,63.01],[13.46,63.27],[12.37,63.62],[11.30,64.05],[10.26,64.55],[9.26,65.13],[8.31,65.79],[7.42,66.51],[6.57,67.29],[5.79,68.13],[5.07,69.03],[4.42,69.98],[3.84,70.98],[3.37,71.93],[4.41,72.80],[5.15,71.28],[6.11,69.81],[7.24,68.46],[8.53,67.26],[9.96,66.23],[11.50,65.38],[13.14,64.73],[14.84,64.28],[16.23,64.08],[17.99,64.01],[19.74,64.16],[21.12,64.44],[22.47,64.85],[24.09,65.54],[25.31,66.23],[26.74,67.26],[28.03,68.46],[28.95,69.53],[29.76,70.68],[30.61,72.22],[31.26,73.85],[31.64,75.21],[31.88,76.60],[31.99,78.36],[31.88,80.11],[31.56,81.84],[31.03,83.52],[30.29,85.12],[29.37,86.62],[28.27,87.99],[27.01,89.22],[26.19,89.88],[25.41,90.42],[26.45,91.29],[27.57,90.45],[28.43,89.69],[29.23,88.87],[30.21,87.68],[31.06,86.40],[31.62,85.39],[32.10,84.35],[32.61,82.90],[32.91,81.79],[33.12,80.65],[33.25,79.51],[33.28,77.97],[33.17,76.44],[32.99,75.30],[32.72,74.18]], paths=[[0, 1, 2, 3, 4, 5, 6, 7, 8, 9, 10, 11, 12, 13, 14, 15, 16, 17, 18, 19, 20, 21, 22, 23, 24, 25, 26, 27, 28, 29, 30, 31, 32, 33, 34, 35, 36, 37, 38, 39, 40, 41, 42, 43, 44, 45, 46, 47, 48, 49, 50, 51, 52, 53, 54, 55, 56, 57, 58, 59, 60, 61, 62, 63, 64, 65, 66, 67, 68, 69, 70, 71, 72, 73, 74, 75, 76, 77, 78, 79, 80, 81, 82]]);
  polygon(points=[[44.54,77.08],[42.05,77.60],[39.50,78.38],[36.95,79.34],[35.41,80.06],[35.19,81.60],[37.43,80.55],[39.90,79.62],[42.36,78.87],[44.80,78.36]], paths=[[0, 1, 2, 3, 4, 5, 6, 7, 8, 9]]);
  polygon(points=[[38.48,82.97],[37.18,83.43],[35.68,84.09],[34.25,84.88],[33.77,85.99],[33.27,86.97],[33.78,86.63],[36.23,85.26],[37.68,84.63],[38.88,84.20],[40.32,83.83],[41.49,83.65],[43.38,83.64],[45.02,83.95],[46.45,84.45],[47.82,85.07],[47.07,83.92],[46.63,83.14],[45.31,82.68],[43.44,82.34],[41.44,82.35],[40.03,82.57]], paths=[[0, 1, 2, 3, 4, 5, 6, 7, 8, 9, 10, 11, 12, 13, 14, 15, 16, 17, 18, 19, 20, 21]]);
  polygon(points=[[38.79,86.95],[36.97,87.39],[34.97,88.10],[31.32,89.82],[29.95,91.28],[28.41,92.59],[29.13,92.29],[35.44,89.32],[37.38,88.63],[39.06,88.22],[40.73,88.02],[42.65,88.05],[44.34,88.27],[49.08,89.11],[51.90,89.37],[51.13,88.74],[50.23,87.92],[49.28,87.83],[44.56,86.99],[42.78,86.76],[40.70,86.72]], paths=[[0, 1, 2, 3, 4, 5, 6, 7, 8, 9, 10, 11, 12, 13, 14, 15, 16, 17, 18, 19, 20]]);
  polygon(points=[[34.87,92.87],[36.82,92.40],[38.76,92.12],[40.95,92.00],[45.93,92.09],[48.71,92.02],[51.99,91.78],[55.22,91.46],[54.31,90.98],[53.27,90.35],[48.66,90.72],[45.94,90.79],[40.95,90.70],[38.66,90.82],[36.60,91.12],[34.54,91.61],[29.01,93.44],[30.18,94.42]], paths=[[0, 1, 2, 3, 4, 5, 6, 7, 8, 9, 10, 11, 12, 13, 14, 15, 16, 17]]);
  polygon(points=[[34.53,96.23],[36.99,95.98],[41.98,95.72],[44.52,95.43],[54.30,93.50],[58.75,92.83],[57.41,92.40],[56.16,91.90],[54.07,92.22],[44.34,94.14],[41.89,94.42],[36.88,94.68],[34.33,94.94],[31.41,95.45],[32.71,96.54]], paths=[[0, 1, 2, 3, 4, 5, 6, 7, 8, 9, 10, 11, 12, 13, 14]]);
  polygon(points=[[38.18,99.74],[40.74,99.53],[42.12,99.26],[43.66,98.83],[50.01,96.57],[53.60,95.52],[57.80,94.66],[62.25,94.12],[64.97,93.94],[67.69,93.87],[70.17,93.93],[75.66,94.24],[78.77,94.15],[81.82,93.76],[83.55,92.79],[84.56,92.31],[85.86,91.79],[81.35,92.52],[78.64,92.85],[75.70,92.94],[70.10,92.63],[68.92,92.97],[67.49,93.27],[66.04,93.47],[65.07,93.54],[63.61,93.55],[62.64,93.51],[61.19,93.35],[59.85,93.10],[57.61,93.37],[53.26,94.26],[49.59,95.34],[43.25,97.60],[41.79,98.01],[40.60,98.24],[38.17,98.44],[34.88,98.37],[36.47,99.70]], paths=[[0, 1, 2, 3, 4, 5, 6, 7, 8, 9, 10, 11, 12, 13, 14, 15, 16, 17, 18, 19, 20, 21, 22, 23, 24, 25, 26, 27, 28, 29, 30, 31, 32, 33, 34, 35, 36, 37]]);
  polygon(points=[[68.62,124.80],[70.56,124.32],[72.71,124.07],[73.77,124.15],[73.08,122.79],[72.74,122.77],[70.29,123.05],[68.25,123.55],[65.81,124.32],[66.99,125.31]], paths=[[0, 1, 2, 3, 4, 5, 6, 7, 8, 9]]);
  polygon(points=[[69.79,127.22],[71.95,127.02],[73.59,127.13],[75.22,127.56],[76.59,128.21],[75.81,127.26],[75.00,126.16],[73.86,125.86],[71.88,125.72],[69.63,125.93],[68.11,126.25],[69.38,127.31]], paths=[[0, 1, 2, 3, 4, 5, 6, 7, 8, 9, 10, 11]]);
  polygon(points=[[72.85,129.82],[74.49,130.21],[76.15,130.93],[77.60,131.77],[81.15,134.07],[83.40,135.20],[84.47,135.59],[85.78,135.93],[87.16,136.12],[88.49,136.18],[90.99,135.99],[91.36,135.92],[89.92,135.72],[88.27,135.37],[87.19,135.07],[85.73,134.57],[84.88,134.36],[83.95,134.03],[81.77,132.93],[78.30,130.67],[76.77,129.78],[74.95,128.99],[72.98,128.52],[70.98,128.41],[70.70,128.42],[72.32,129.79]], paths=[[0, 1, 2, 3, 4, 5, 6, 7, 8, 9, 10, 11, 12, 13, 14, 15, 16, 17, 18, 19, 20, 21, 22, 23, 24, 25]]);
  polygon(points=[[80.32,136.26],[82.42,137.23],[84.51,137.84],[86.97,138.10],[89.04,138.01],[91.35,137.64],[94.15,136.92],[97.70,135.72],[96.06,135.94],[94.94,136.03],[93.82,136.05],[92.47,136.01],[91.06,136.37],[88.88,136.72],[86.96,136.80],[84.82,136.57],[82.92,136.03],[80.95,135.12],[77.24,132.93],[75.74,132.15],[74.65,131.74],[79.37,135.70]], paths=[[0, 1, 2, 3, 4, 5, 6, 7, 8, 9, 10, 11, 12, 13, 14, 15, 16, 17, 18, 19, 20, 21]]);
  polygon(points=[[85.62,140.16],[87.27,140.12],[89.02,139.90],[90.86,139.52],[92.86,138.97],[96.66,137.71],[109.90,132.97],[115.13,131.36],[115.13,130.01],[109.47,131.74],[103.70,133.81],[102.57,134.31],[101.52,134.72],[100.46,135.07],[99.28,135.39],[96.23,136.49],[92.50,137.72],[90.54,138.26],[88.84,138.61],[87.14,138.82],[85.72,138.86],[83.57,138.63],[82.49,138.32],[84.54,140.04]], paths=[[0, 1, 2, 3, 4, 5, 6, 7, 8, 9, 10, 11, 12, 13, 14, 15, 16, 17, 18, 19, 20, 21, 22, 23]]);
  polygon(points=[[90.88,145.36],[92.76,144.59],[93.70,143.61],[94.46,142.93],[95.55,142.12],[96.58,141.50],[91.20,143.85],[89.73,144.39]], paths=[[0, 1, 2, 3, 4, 5, 6, 7]]);
  polygon(points=[[91.68,146.02],[91.79,145.85],[91.59,145.95]], paths=[[0, 1, 2]]);
  polygon(points=[[59.51,6.33],[58.24,6.20],[55.08,6.20],[53.56,6.35],[54.27,7.59],[55.24,7.49],[57.42,7.42],[59.33,7.62],[60.02,7.79],[60.25,6.51]], paths=[[0, 1, 2, 3, 4, 5, 6, 7, 8, 9]]);
  polygon(points=[[81.92,7.98],[81.40,7.01],[80.75,6.20],[78.53,6.20],[79.21,6.59],[79.78,7.07],[80.26,7.64],[80.68,8.38],[80.92,9.09],[81.05,9.93],[81.02,10.68],[80.83,11.51],[80.49,12.29],[80.07,12.91],[79.46,13.51],[78.85,13.93],[78.17,14.24],[77.34,14.45],[76.60,14.50],[75.86,14.41],[75.24,14.24],[74.56,13.93],[74.03,13.58],[73.55,13.15],[73.15,12.65],[72.77,12.01],[72.54,11.41],[72.39,10.68],[72.36,9.93],[72.44,9.30],[72.61,8.68],[72.92,8.00],[73.34,7.39],[73.78,6.92],[74.29,6.53],[74.88,6.20],[72.66,6.20],[72.17,6.78],[71.72,7.48],[71.38,8.24],[71.16,9.04],[71.06,9.87],[71.08,10.70],[71.22,11.52],[71.48,12.31],[72.01,13.29],[72.71,14.14],[73.57,14.84],[74.54,15.37],[75.60,15.69],[76.70,15.80],[77.81,15.69],[78.87,15.37],[79.84,14.84],[80.70,14.14],[81.40,13.29],[81.92,12.31],[82.25,11.25],[82.35,10.15],[82.25,9.04]], paths=[[0, 1, 2, 3, 4, 5, 6, 7, 8, 9, 10, 11, 12, 13, 14, 15, 16, 17, 18, 19, 20, 21, 22, 23, 24, 25, 26, 27, 28, 29, 30, 31, 32, 33, 34, 35, 36, 37, 38, 39, 40, 41, 42, 43, 44, 45, 46, 47, 48, 49, 50, 51, 52, 53, 54, 55, 56, 57, 58, 59]]);
  polygon(points=[[77.63,9.39],[77.27,9.09],[76.82,8.95],[76.36,9.00],[75.94,9.22],[75.65,9.58],[75.51,10.03],[75.56,10.50],[75.78,10.91],[76.14,11.21],[76.59,11.34],[77.05,11.30],[77.47,11.07],[77.76,10.71],[77.90,10.26],[77.85,9.80]], paths=[[0, 1, 2, 3, 4, 5, 6, 7, 8, 9, 10, 11, 12, 13, 14, 15]]);
  polygon(points=[[84.92,7.43],[84.40,6.20],[82.90,6.20],[83.35,7.00],[83.68,7.84],[83.91,8.71],[84.03,9.61],[84.05,10.51],[83.95,11.40],[83.74,12.28],[83.35,13.29],[82.71,14.38],[81.90,15.34],[80.94,16.16],[80.33,16.54],[79.68,16.87],[78.66,17.23],[77.42,17.46],[76.16,17.48],[75.09,17.32],[74.06,17.00],[72.93,16.45],[72.04,15.83],[71.14,14.95],[70.40,13.93],[69.91,12.96],[69.53,11.76],[69.37,10.69],[69.39,9.43],[69.57,8.36],[69.98,7.17],[70.50,6.20],[69.01,6.20],[68.56,7.23],[68.26,8.25],[68.15,8.88],[68.06,9.72],[68.10,10.99],[68.22,11.83],[68.37,12.45],[68.80,13.65],[69.18,14.41],[69.63,15.13],[70.15,15.80],[70.74,16.41],[71.38,16.97],[72.08,17.45],[72.81,17.87],[73.59,18.22],[74.40,18.48],[75.23,18.67],[76.07,18.77],[76.92,18.79],[77.76,18.73],[78.60,18.59],[79.42,18.36],[80.21,18.05],[80.97,17.67],[81.68,17.22],[82.35,16.70],[82.97,16.11],[83.52,15.47],[84.01,14.77],[84.43,14.04],[84.77,13.26],[85.04,12.45],[85.23,11.63],[85.33,10.78],[85.35,9.93],[85.29,9.09],[85.14,8.25]], paths=[[0, 1, 2, 3, 4, 5, 6, 7, 8, 9, 10, 11, 12, 13, 14, 15, 16, 17, 18, 19, 20, 21, 22, 23, 24, 25, 26, 27, 28, 29, 30, 31, 32, 33, 34, 35, 36, 37, 38, 39, 40, 41, 42, 43, 44, 45, 46, 47, 48, 49, 50, 51, 52, 53, 54, 55, 56, 57, 58, 59, 60, 61, 62, 63, 64, 65, 66, 67, 68, 69, 70]]);
  polygon(points=[[62.60,6.20],[62.27,7.64],[62.09,9.07],[62.06,10.51],[62.16,11.94],[62.41,13.36],[62.79,14.74],[63.31,16.08],[63.96,17.37],[64.73,18.58],[65.61,19.72],[66.60,20.76],[67.69,21.70],[68.87,22.52],[70.12,23.23],[71.43,23.82],[72.80,24.27],[74.20,24.58],[75.63,24.76],[77.06,24.79],[78.50,24.69],[79.91,24.44],[81.30,24.06],[82.64,23.54],[83.93,22.89],[85.14,22.12],[86.27,21.24],[87.31,20.25],[88.25,19.16],[89.08,17.98],[89.79,16.73],[90.37,15.42],[90.82,14.05],[91.14,12.65],[91.34,10.87],[91.34,9.43],[91.14,7.64],[90.81,6.20],[89.46,6.20],[89.86,7.86],[90.04,9.49],[90.05,10.47],[89.99,11.46],[89.73,13.07],[89.48,14.02],[89.16,14.95],[88.48,16.44],[87.62,17.83],[87.02,18.62],[86.37,19.35],[85.17,20.47],[84.39,21.06],[83.57,21.60],[82.71,22.07],[81.81,22.48],[80.26,23.01],[79.31,23.24],[78.34,23.40],[76.70,23.50],[75.07,23.40],[74.10,23.24],[73.14,23.01],[71.90,22.60],[70.70,22.07],[69.56,21.43],[68.75,20.87],[67.74,20.04],[66.81,19.11],[65.98,18.10],[65.43,17.29],[64.64,15.85],[64.13,14.64],[63.75,13.39],[63.45,11.78],[63.36,10.47],[63.42,8.84],[63.61,7.54],[63.95,6.20]], paths=[[0, 1, 2, 3, 4, 5, 6, 7, 8, 9, 10, 11, 12, 13, 14, 15, 16, 17, 18, 19, 20, 21, 22, 23, 24, 25, 26, 27, 28, 29, 30, 31, 32, 33, 34, 35, 36, 37, 38, 39, 40, 41, 42, 43, 44, 45, 46, 47, 48, 49, 50, 51, 52, 53, 54, 55, 56, 57, 58, 59, 60, 61, 62, 63, 64, 65, 66, 67, 68, 69, 70, 71, 72, 73, 74, 75, 76, 77]]);
  polygon(points=[[87.66,6.20],[86.27,6.20],[86.68,7.39],[86.90,8.38],[87.04,9.64],[87.04,10.65],[86.94,11.67],[86.68,12.91],[86.27,14.11],[85.83,15.03],[85.45,15.68],[84.86,16.51],[84.20,17.28],[83.46,17.98],[82.66,18.61],[81.81,19.15],[81.13,19.50],[80.19,19.89],[78.72,20.30],[77.21,20.48],[75.69,20.45],[74.19,20.19],[72.74,19.71],[71.60,19.15],[70.34,18.31],[69.21,17.28],[68.24,16.11],[67.58,15.03],[66.96,13.63],[66.55,12.17],[66.37,10.65],[66.40,9.13],[66.66,7.63],[67.14,6.20],[65.74,6.20],[65.48,7.04],[65.23,8.16],[65.07,9.58],[65.09,11.00],[65.18,11.86],[65.34,12.70],[65.74,14.07],[66.17,15.13],[66.71,16.14],[67.35,17.09],[68.07,17.97],[68.88,18.78],[69.76,19.50],[70.71,20.14],[71.72,20.68],[72.78,21.12],[73.87,21.45],[74.99,21.67],[76.13,21.78],[77.28,21.78],[78.41,21.67],[79.53,21.45],[80.63,21.12],[81.69,20.68],[82.69,20.14],[83.64,19.50],[84.53,18.78],[85.34,17.97],[86.06,17.09],[86.70,16.14],[87.24,15.13],[87.67,14.07],[88.00,12.98],[88.23,11.86],[88.34,10.72],[88.34,9.58],[88.23,8.44],[88.00,7.32]], paths=[[0, 1, 2, 3, 4, 5, 6, 7, 8, 9, 10, 11, 12, 13, 14, 15, 16, 17, 18, 19, 20, 21, 22, 23, 24, 25, 26, 27, 28, 29, 30, 31, 32, 33, 34, 35, 36, 37, 38, 39, 40, 41, 42, 43, 44, 45, 46, 47, 48, 49, 50, 51, 52, 53, 54, 55, 56, 57, 58, 59, 60, 61, 62, 63, 64, 65, 66, 67, 68, 69, 70, 71, 72]]);
  polygon(points=[[62.86,20.83],[63.89,21.09],[63.17,20.18],[62.62,19.40],[61.62,19.09],[60.50,18.62],[59.69,18.16],[58.78,17.46],[57.85,16.51],[57.28,15.85],[57.67,18.19],[57.88,18.40],[58.93,19.22],[59.96,19.80],[61.20,20.32]], paths=[[0, 1, 2, 3, 4, 5, 6, 7, 8, 9, 10, 11, 12, 13, 14]]);
  polygon(points=[[66.67,23.68],[65.66,22.87],[64.62,22.89],[62.87,23.08],[61.00,23.46],[59.42,23.97],[57.75,24.75],[57.54,26.43],[58.50,25.81],[59.93,25.17],[61.36,24.71],[63.04,24.37],[64.73,24.19],[66.43,24.16],[67.45,24.23]], paths=[[0, 1, 2, 3, 4, 5, 6, 7, 8, 9, 10, 11, 12, 13, 14]]);
  polygon(points=[[56.51,34.52],[57.03,32.72],[57.58,31.51],[58.43,30.16],[59.48,28.95],[60.69,27.91],[62.03,27.06],[63.49,26.41],[65.03,25.98],[66.35,25.80],[67.41,25.78],[68.74,25.89],[69.78,26.10],[70.80,26.41],[71.76,26.80],[72.77,27.05],[74.38,27.56],[80.46,29.91],[82.04,30.29],[82.88,30.35],[83.91,29.08],[83.67,29.11],[82.29,29.01],[80.88,28.68],[76.52,26.99],[75.46,26.95],[74.23,26.81],[73.01,26.59],[72.21,26.39],[70.64,25.87],[68.80,25.03],[67.66,24.97],[66.08,25.06],[64.50,25.34],[63.00,25.81],[61.67,26.42],[60.34,27.27],[59.21,28.23],[58.22,29.31],[57.45,30.37],[55.33,33.94],[54.71,35.27],[53.65,37.19],[52.86,38.43],[51.79,39.93],[52.98,38.91],[54.46,37.39],[56.05,35.28]], paths=[[0, 1, 2, 3, 4, 5, 6, 7, 8, 9, 10, 11, 12, 13, 14, 15, 16, 17, 18, 19, 20, 21, 22, 23, 24, 25, 26, 27, 28, 29, 30, 31, 32, 33, 34, 35, 36, 37, 38, 39, 40, 41, 42, 43, 44, 45, 46, 47]]);
  polygon(points=[[68.04,35.82],[67.66,35.54],[67.21,35.43],[66.74,35.49],[66.34,35.74],[66.06,36.11],[65.95,36.57],[66.02,37.03],[66.26,37.43],[66.64,37.71],[67.09,37.82],[67.55,37.75],[67.95,37.51],[68.23,37.14],[68.35,36.68],[68.28,36.22]], paths=[[0, 1, 2, 3, 4, 5, 6, 7, 8, 9, 10, 11, 12, 13, 14, 15]]);
  polygon(points=[[72.37,34.46],[71.85,33.49],[71.14,32.63],[70.29,31.93],[69.31,31.40],[68.25,31.08],[67.15,30.97],[66.05,31.08],[64.99,31.40],[64.01,31.93],[63.15,32.63],[62.45,33.49],[61.93,34.46],[61.61,35.52],[61.50,36.62],[61.61,37.73],[61.93,38.79],[62.45,39.76],[63.15,40.62],[64.01,41.32],[64.99,41.84],[66.05,42.17],[67.15,42.27],[68.25,42.17],[69.31,41.84],[70.29,41.32],[71.14,40.62],[71.85,39.76],[72.37,38.79],[72.69,37.73],[72.80,36.62],[72.69,35.52],[71.17,38.29],[70.77,39.04],[70.22,39.70],[69.57,40.24],[68.81,40.64],[68.00,40.89],[67.15,40.97],[66.30,40.89],[65.48,40.64],[64.73,40.24],[64.07,39.70],[63.53,39.04],[63.13,38.29],[62.88,37.47],[62.80,36.62],[62.88,35.78],[63.13,34.96],[63.53,34.21],[64.07,33.55],[64.73,33.01],[65.48,32.61],[66.30,32.36],[67.15,32.27],[68.00,32.36],[68.81,32.61],[69.57,33.01],[70.22,33.55],[70.77,34.21],[71.17,34.96],[71.41,35.78],[71.50,36.62],[71.41,37.47]], paths=[[0, 1, 2, 3, 4, 5, 6, 7, 8, 9, 10, 11, 12, 13, 14, 15, 16, 17, 18, 19, 20, 21, 22, 23, 24, 25, 26, 27, 28, 29, 30, 31], [32, 33, 34, 35, 36, 37, 38, 39, 40, 41, 42, 43, 44, 45, 46, 47, 48, 49, 50, 51, 52, 53, 54, 55, 56, 57, 58, 59, 60, 61, 62, 63]]);
  polygon(points=[[75.22,33.51],[74.87,32.74],[74.46,32.00],[73.97,31.30],[73.41,30.66],[72.80,30.07],[72.13,29.55],[71.41,29.10],[70.65,28.72],[69.86,28.41],[69.04,28.18],[68.21,28.04],[67.36,27.98],[66.51,28.00],[65.67,28.10],[64.84,28.29],[64.04,28.55],[63.26,28.90],[62.52,29.32],[61.83,29.81],[61.18,30.36],[60.60,30.97],[60.08,31.64],[59.62,32.36],[59.24,33.12],[58.94,33.91],[58.71,34.73],[58.56,35.57],[58.50,36.41],[58.52,37.26],[58.63,38.10],[58.81,38.93],[59.08,39.74],[59.42,40.51],[59.84,41.25],[60.33,41.95],[60.88,42.59],[61.50,43.17],[62.17,43.70],[62.88,44.15],[63.64,44.53],[64.44,44.84],[65.25,45.06],[66.09,45.21],[66.94,45.27],[67.78,45.25],[68.63,45.15],[69.46,44.96],[70.26,44.70],[71.04,44.35],[71.78,43.93],[72.47,43.44],[73.11,42.89],[73.70,42.27],[74.22,41.61],[74.67,40.89],[75.06,40.13],[75.36,39.34],[75.59,38.52],[75.73,37.68],[75.80,36.84],[75.78,35.99],[75.67,35.15],[75.49,34.32],[74.01,39.27],[73.71,39.93],[73.36,40.56],[72.94,41.15],[72.47,41.69],[71.95,42.19],[71.38,42.63],[70.77,43.02],[70.13,43.34],[69.45,43.60],[68.76,43.80],[68.05,43.92],[67.33,43.97],[66.61,43.95],[65.89,43.87],[65.19,43.71],[64.50,43.48],[63.84,43.19],[63.22,42.83],[62.63,42.42],[62.08,41.95],[61.58,41.43],[61.14,40.86],[60.75,40.25],[60.43,39.60],[60.17,38.93],[59.98,38.24],[59.85,37.52],[59.80,36.80],[59.82,36.08],[59.91,35.37],[60.06,34.66],[60.29,33.98],[60.58,33.32],[60.94,32.69],[61.35,32.10],[61.83,31.56],[62.35,31.06],[62.92,30.62],[63.53,30.23],[64.17,29.91],[64.84,29.65],[65.54,29.45],[66.25,29.33],[66.97,29.28],[67.69,29.29],[68.41,29.38],[69.11,29.54],[69.79,29.77],[70.45,30.06],[71.08,30.41],[71.67,30.83],[72.22,31.30],[72.71,31.82],[73.16,32.39],[73.54,33.00],[73.87,33.65],[74.13,34.32],[74.32,35.01],[74.44,35.72],[74.50,36.44],[74.48,37.17],[74.39,37.88],[74.23,38.58]], paths=[[0, 1, 2, 3, 4, 5, 6, 7, 8, 9, 10, 11, 12, 13, 14, 15, 16, 17, 18, 19, 20, 21, 22, 23, 24, 25, 26, 27, 28, 29, 30, 31, 32, 33, 34, 35, 36, 37, 38, 39, 40, 41, 42, 43, 44, 45, 46, 47, 48, 49, 50, 51, 52, 53, 54, 55, 56, 57, 58, 59, 60, 61, 62, 63], [64, 65, 66, 67, 68, 69, 70, 71, 72, 73, 74, 75, 76, 77, 78, 79, 80, 81, 82, 83, 84, 85, 86, 87, 88, 89, 90, 91, 92, 93, 94, 95, 96, 97, 98, 99, 100, 101, 102, 103, 104, 105, 106, 107, 108, 109, 110, 111, 112, 113, 114, 115, 116, 117, 118, 119, 120, 121, 122, 123, 124, 125, 126, 127]]);
  polygon(points=[[77.38,40.23],[76.79,41.59],[78.04,41.50],[78.31,40.18]], paths=[[0, 1, 2, 3]]);
  polygon(points=[[73.37,45.51],[72.03,46.32],[71.23,46.68],[73.39,46.82],[77.69,47.24],[77.66,45.93]], paths=[[0, 1, 2, 3, 4, 5]]);
  polygon(points=[[60.98,47.88],[62.16,47.87],[65.09,48.21],[69.30,49.04],[76.03,50.76],[78.22,51.26],[77.96,49.87],[69.60,47.78],[67.94,47.45],[66.88,47.47],[65.82,47.39],[64.51,47.15],[63.03,46.66],[62.19,46.57],[60.94,46.58],[59.62,46.72],[58.31,47.00],[56.68,47.53],[54.13,48.68],[48.91,51.50],[47.71,52.03],[47.19,52.19],[48.03,53.29],[49.50,52.65],[54.73,49.83],[57.18,48.73],[58.61,48.26],[59.80,48.01]], paths=[[0, 1, 2, 3, 4, 5, 6, 7, 8, 9, 10, 11, 12, 13, 14, 15, 16, 17, 18, 19, 20, 21, 22, 23, 24, 25, 26, 27]]);
  polygon(points=[[61.45,48.94],[59.81,49.09],[58.50,49.37],[57.00,49.84],[55.40,50.50],[53.65,51.39],[51.89,52.40],[48.68,54.49],[49.13,55.76],[50.24,54.99],[52.58,53.51],[54.28,52.52],[55.96,51.67],[57.41,51.07],[58.86,50.62],[60.04,50.37],[61.47,50.24],[62.66,50.24],[64.10,50.38],[65.56,50.64],[67.26,51.06],[74.49,53.40],[79.25,54.85],[78.74,53.34],[74.89,52.17],[67.60,49.80],[65.85,49.37],[64.31,49.10],[62.76,48.95]], paths=[[0, 1, 2, 3, 4, 5, 6, 7, 8, 9, 10, 11, 12, 13, 14, 15, 16, 17, 18, 19, 20, 21, 22, 23, 24, 25, 26, 27, 28]]);
  polygon(points=[[64.09,52.79],[65.54,53.08],[67.00,53.48],[77.96,57.36],[80.41,58.37],[81.04,58.71],[80.06,56.82],[78.41,56.14],[67.36,52.23],[65.82,51.81],[64.26,51.50],[62.76,51.34],[61.45,51.33],[60.14,51.44],[59.08,51.63],[56.75,52.34],[54.16,53.59],[51.84,55.11],[50.02,56.62],[49.41,57.30],[49.43,58.52],[49.32,59.52],[49.77,58.85],[50.90,57.59],[52.58,56.17],[54.76,54.75],[57.18,53.57],[59.35,52.90],[60.28,52.73],[61.47,52.63],[62.65,52.64]], paths=[[0, 1, 2, 3, 4, 5, 6, 7, 8, 9, 10, 11, 12, 13, 14, 15, 16, 17, 18, 19, 20, 21, 22, 23, 24, 25, 26, 27, 28, 29, 30]]);
  polygon(points=[[55.42,55.41],[53.39,56.70],[51.91,57.95],[51.57,58.32],[53.07,57.21],[54.31,56.44],[56.05,55.56],[57.41,55.02],[59.27,54.46],[60.70,54.15],[62.64,53.91],[64.16,53.86],[62.76,53.71],[61.45,53.69],[59.36,53.94],[57.26,54.56]], paths=[[0, 1, 2, 3, 4, 5, 6, 7, 8, 9, 10, 11, 12, 13, 14, 15]]);
  polygon(points=[[74.75,68.99],[74.23,67.97],[73.62,67.00],[72.92,66.10],[72.13,65.27],[71.27,64.53],[70.33,63.87],[69.34,63.30],[68.29,62.84],[67.20,62.48],[66.09,62.23],[64.95,62.09],[63.81,62.06],[62.67,62.15],[61.55,62.34],[60.44,62.65],[59.38,63.06],[58.36,63.57],[57.39,64.19],[56.49,64.89],[55.66,65.68],[54.91,66.54],[54.26,67.48],[53.69,68.47],[53.23,69.52],[52.87,70.60],[52.62,71.72],[52.48,72.85],[52.45,74.00],[52.54,75.14],[52.73,76.26],[53.04,77.37],[53.45,78.43],[53.96,79.45],[54.57,80.42],[55.28,81.32],[56.06,82.15],[56.93,82.90],[57.86,83.55],[58.86,84.12],[59.90,84.58],[60.99,84.94],[62.11,85.19],[63.24,85.33],[64.38,85.36],[65.52,85.27],[66.65,85.08],[67.75,84.77],[68.82,84.36],[69.84,83.85],[70.81,83.24],[71.71,82.53],[72.54,81.74],[73.28,80.88],[73.94,79.94],[74.50,78.95],[74.97,77.90],[75.33,76.82],[75.58,75.70],[75.72,74.57],[75.74,73.43],[75.66,72.28],[75.46,71.16],[75.16,70.06],[73.56,77.91],[73.10,78.81],[72.56,79.67],[71.93,80.47],[71.23,81.21],[70.47,81.87],[69.63,82.46],[68.75,82.96],[67.82,83.37],[66.86,83.69],[65.87,83.91],[64.86,84.03],[63.84,84.06],[62.83,83.98],[61.83,83.81],[60.85,83.54],[59.90,83.17],[59.00,82.72],[58.14,82.17],[57.34,81.55],[56.60,80.85],[55.94,80.08],[55.35,79.25],[54.85,78.36],[54.44,77.44],[54.12,76.47],[53.90,75.48],[53.78,74.47],[53.75,73.46],[53.83,72.44],[54.00,71.44],[54.27,70.46],[54.64,69.52],[55.09,68.61],[55.64,67.75],[56.26,66.95],[56.96,66.22],[57.73,65.55],[58.56,64.97],[59.44,64.47],[60.37,64.05],[61.34,63.74],[62.33,63.51],[63.34,63.39],[64.35,63.36],[65.36,63.44],[66.37,63.61],[67.34,63.88],[68.29,64.25],[69.20,64.71],[70.06,65.25],[70.86,65.87],[71.59,66.57],[72.26,67.34],[72.84,68.17],[73.34,69.06],[73.75,69.99],[74.07,70.95],[74.30,71.94],[74.42,72.95],[74.44,73.96],[74.37,74.98],[74.20,75.98],[73.93,76.96]], paths=[[0, 1, 2, 3, 4, 5, 6, 7, 8, 9, 10, 11, 12, 13, 14, 15, 16, 17, 18, 19, 20, 21, 22, 23, 24, 25, 26, 27, 28, 29, 30, 31, 32, 33, 34, 35, 36, 37, 38, 39, 40, 41, 42, 43, 44, 45, 46, 47, 48, 49, 50, 51, 52, 53, 54, 55, 56, 57, 58, 59, 60, 61, 62, 63], [64, 65, 66, 67, 68, 69, 70, 71, 72, 73, 74, 75, 76, 77, 78, 79, 80, 81, 82, 83, 84, 85, 86, 87, 88, 89, 90, 91, 92, 93, 94, 95, 96, 97, 98, 99, 100, 101, 102, 103, 104, 105, 106, 107, 108, 109, 110, 111, 112, 113, 114, 115, 116, 117, 118, 119, 120, 121, 122, 123, 124, 125, 126, 127]]);
  polygon(points=[[77.63,68.10],[77.02,66.81],[76.28,65.57],[75.42,64.42],[74.46,63.35],[73.39,62.39],[72.24,61.53],[71.00,60.79],[69.70,60.18],[68.35,59.69],[66.96,59.34],[65.53,59.13],[64.10,59.06],[62.66,59.13],[61.24,59.34],[59.84,59.69],[58.49,60.18],[57.19,60.79],[55.96,61.53],[54.80,62.39],[53.74,63.35],[52.77,64.42],[51.92,65.57],[51.18,66.81],[50.56,68.10],[50.08,69.46],[49.73,70.85],[49.52,72.28],[49.45,73.71],[49.52,75.15],[49.73,76.57],[50.08,77.96],[50.56,79.32],[51.18,80.62],[51.92,81.85],[52.77,83.00],[53.74,84.07],[54.80,85.04],[55.96,85.89],[57.19,86.63],[58.49,87.25],[59.84,87.73],[61.24,88.08],[62.66,88.29],[64.10,88.36],[65.53,88.29],[66.96,88.08],[68.35,87.73],[69.70,87.25],[71.00,86.63],[72.24,85.89],[73.39,85.04],[74.46,84.07],[75.42,83.00],[76.28,81.85],[77.02,80.62],[77.63,79.32],[78.12,77.96],[78.47,76.57],[78.68,75.15],[78.75,73.71],[78.68,72.28],[78.47,70.85],[78.12,69.46],[76.43,78.82],[75.87,80.00],[75.20,81.13],[74.42,82.18],[73.54,83.15],[72.57,84.03],[71.51,84.81],[70.39,85.48],[69.21,86.04],[67.97,86.49],[66.70,86.80],[65.41,87.00],[64.10,87.06],[62.79,87.00],[61.49,86.80],[60.22,86.49],[58.99,86.04],[57.80,85.48],[56.68,84.81],[55.63,84.03],[54.66,83.15],[53.78,82.18],[53.00,81.13],[52.32,80.00],[51.76,78.82],[51.32,77.59],[51.00,76.32],[50.81,75.02],[50.75,73.71],[50.81,72.40],[51.00,71.11],[51.32,69.84],[51.76,68.60],[52.32,67.42],[53.00,66.29],[53.78,65.24],[54.66,64.27],[55.63,63.39],[56.68,62.61],[57.80,61.94],[58.99,61.38],[60.22,60.94],[61.49,60.62],[62.79,60.43],[64.10,60.36],[65.41,60.43],[66.70,60.62],[67.97,60.94],[69.21,61.38],[70.39,61.94],[71.51,62.61],[72.57,63.39],[73.54,64.27],[74.42,65.24],[75.20,66.29],[75.87,67.42],[76.43,68.60],[76.87,69.84],[77.19,71.11],[77.38,72.40],[77.45,73.71],[77.38,75.02],[77.19,76.32],[76.87,77.59]], paths=[[0, 1, 2, 3, 4, 5, 6, 7, 8, 9, 10, 11, 12, 13, 14, 15, 16, 17, 18, 19, 20, 21, 22, 23, 24, 25, 26, 27, 28, 29, 30, 31, 32, 33, 34, 35, 36, 37, 38, 39, 40, 41, 42, 43, 44, 45, 46, 47, 48, 49, 50, 51, 52, 53, 54, 55, 56, 57, 58, 59, 60, 61, 62, 63], [64, 65, 66, 67, 68, 69, 70, 71, 72, 73, 74, 75, 76, 77, 78, 79, 80, 81, 82, 83, 84, 85, 86, 87, 88, 89, 90, 91, 92, 93, 94, 95, 96, 97, 98, 99, 100, 101, 102, 103, 104, 105, 106, 107, 108, 109, 110, 111, 112, 113, 114, 115, 116, 117, 118, 119, 120, 121, 122, 123, 124, 125, 126, 127]]);
  polygon(points=[[80.56,67.36],[79.86,65.78],[79.01,64.27],[78.01,62.85],[76.88,61.54],[75.63,60.35],[74.26,59.28],[72.80,58.35],[71.25,57.58],[69.63,56.95],[67.96,56.49],[66.26,56.19],[64.53,56.07],[62.80,56.11],[61.08,56.32],[59.39,56.70],[57.75,57.24],[56.16,57.95],[54.65,58.80],[53.24,59.80],[51.93,60.93],[50.73,62.18],[49.67,63.55],[48.74,65.01],[47.96,66.56],[47.34,68.17],[46.88,69.84],[46.58,71.55],[46.45,73.28],[46.50,75.01],[46.71,76.73],[47.09,78.42],[47.63,80.06],[48.33,81.65],[49.19,83.15],[50.18,84.57],[51.31,85.88],[52.57,87.08],[53.93,88.14],[55.40,89.07],[56.95,89.85],[58.56,90.47],[60.23,90.93],[61.94,91.23],[63.66,91.36],[65.40,91.31],[67.12,91.10],[68.81,90.72],[70.45,90.18],[72.03,89.48],[73.54,88.62],[74.96,87.63],[76.27,86.49],[77.46,85.24],[78.53,83.87],[79.45,82.41],[80.23,80.86],[80.86,79.25],[81.32,77.58],[81.61,75.87],[81.74,74.14],[81.70,72.41],[81.49,70.69],[81.11,69.00],[79.35,79.60],[78.70,81.06],[77.91,82.46],[76.99,83.77],[75.94,84.98],[74.78,86.09],[73.51,87.08],[72.16,87.94],[70.72,88.66],[69.23,89.24],[67.68,89.66],[66.10,89.94],[64.50,90.06],[62.89,90.02],[61.30,89.82],[59.74,89.47],[58.21,88.97],[56.75,88.32],[55.35,87.52],[54.04,86.60],[52.82,85.55],[51.72,84.39],[50.73,83.13],[49.87,81.77],[49.15,80.34],[48.57,78.84],[48.14,77.29],[47.87,75.71],[47.75,74.11],[47.79,72.51],[47.99,70.92],[48.34,69.35],[48.84,67.83],[49.49,66.36],[50.28,64.96],[51.21,63.65],[52.26,62.44],[53.42,61.33],[54.68,60.34],[56.04,59.49],[57.47,58.76],[58.97,58.19],[60.52,57.76],[62.10,57.48],[63.70,57.37],[65.30,57.41],[66.89,57.60],[68.46,57.95],[69.98,58.46],[71.45,59.11],[72.84,59.90],[74.16,60.82],[75.37,61.87],[76.48,63.03],[77.47,64.30],[78.32,65.65],[79.04,67.09],[79.62,68.58],[80.05,70.13],[80.32,71.71],[80.44,73.31],[80.40,74.91],[80.21,76.51],[79.86,78.07]], paths=[[0, 1, 2, 3, 4, 5, 6, 7, 8, 9, 10, 11, 12, 13, 14, 15, 16, 17, 18, 19, 20, 21, 22, 23, 24, 25, 26, 27, 28, 29, 30, 31, 32, 33, 34, 35, 36, 37, 38, 39, 40, 41, 42, 43, 44, 45, 46, 47, 48, 49, 50, 51, 52, 53, 54, 55, 56, 57, 58, 59, 60, 61, 62, 63], [64, 65, 66, 67, 68, 69, 70, 71, 72, 73, 74, 75, 76, 77, 78, 79, 80, 81, 82, 83, 84, 85, 86, 87, 88, 89, 90, 91, 92, 93, 94, 95, 96, 97, 98, 99, 100, 101, 102, 103, 104, 105, 106, 107, 108, 109, 110, 111, 112, 113, 114, 115, 116, 117, 118, 119, 120, 121, 122, 123, 124, 125, 126, 127]]);
  polygon(points=[[64.99,72.91],[64.61,72.63],[64.16,72.51],[63.69,72.58],[63.29,72.82],[63.01,73.20],[62.90,73.65],[62.97,74.12],[63.21,74.52],[63.58,74.80],[64.04,74.91],[64.50,74.84],[64.90,74.60],[65.18,74.22],[65.30,73.77],[65.23,73.31]], paths=[[0, 1, 2, 3, 4, 5, 6, 7, 8, 9, 10, 11, 12, 13, 14, 15]]);
  polygon(points=[[69.32,71.55],[68.80,70.57],[68.09,69.72],[67.24,69.01],[66.26,68.49],[65.20,68.17],[64.10,68.06],[63.00,68.17],[61.94,68.49],[60.96,69.01],[60.10,69.72],[59.40,70.57],[58.88,71.55],[58.56,72.61],[58.45,73.71],[58.56,74.81],[58.88,75.87],[59.40,76.85],[60.10,77.71],[60.96,78.41],[61.94,78.93],[63.00,79.25],[64.10,79.36],[65.20,79.25],[66.26,78.93],[67.24,78.41],[68.09,77.71],[68.80,76.85],[69.32,75.87],[69.64,74.81],[69.75,73.71],[69.64,72.61],[68.12,75.38],[67.71,76.13],[67.17,76.79],[66.51,77.33],[65.76,77.73],[64.95,77.98],[64.10,78.06],[63.25,77.98],[62.43,77.73],[61.68,77.33],[61.02,76.79],[60.48,76.13],[60.08,75.38],[59.83,74.56],[59.75,73.71],[59.83,72.86],[60.08,72.05],[60.48,71.29],[61.02,70.64],[61.68,70.09],[62.43,69.69],[63.25,69.44],[64.10,69.36],[64.95,69.44],[65.76,69.69],[66.51,70.09],[67.17,70.64],[67.71,71.29],[68.12,72.05],[68.36,72.86],[68.45,73.71],[68.36,74.56]], paths=[[0, 1, 2, 3, 4, 5, 6, 7, 8, 9, 10, 11, 12, 13, 14, 15, 16, 17, 18, 19, 20, 21, 22, 23, 24, 25, 26, 27, 28, 29, 30, 31], [32, 33, 34, 35, 36, 37, 38, 39, 40, 41, 42, 43, 44, 45, 46, 47, 48, 49, 50, 51, 52, 53, 54, 55, 56, 57, 58, 59, 60, 61, 62, 63]]);
  polygon(points=[[72.09,70.40],[71.73,69.63],[71.29,68.91],[70.78,68.22],[70.21,67.59],[69.59,67.02],[68.90,66.52],[68.18,66.08],[67.41,65.72],[66.61,65.43],[65.79,65.23],[64.95,65.10],[64.10,65.06],[63.25,65.10],[62.41,65.23],[61.59,65.43],[60.79,65.72],[60.02,66.08],[59.29,66.52],[58.61,67.02],[57.98,67.59],[57.41,68.22],[56.91,68.91],[56.47,69.63],[56.11,70.40],[55.82,71.20],[55.61,72.02],[55.49,72.86],[55.45,73.71],[55.49,74.56],[55.61,75.40],[55.82,76.22],[56.11,77.02],[56.47,77.79],[56.91,78.52],[57.41,79.20],[57.98,79.83],[58.61,80.40],[59.29,80.90],[60.02,81.34],[60.79,81.70],[61.59,81.99],[62.41,82.19],[63.25,82.32],[64.10,82.36],[64.95,82.32],[65.79,82.19],[66.61,81.99],[67.41,81.70],[68.18,81.34],[68.90,80.90],[69.59,80.40],[70.21,79.83],[70.78,79.20],[71.29,78.52],[71.73,77.79],[72.09,77.02],[72.38,76.22],[72.58,75.40],[72.71,74.56],[72.75,73.71],[72.71,72.86],[72.58,72.02],[72.38,71.20],[70.89,76.52],[70.58,77.18],[70.21,77.79],[69.78,78.37],[69.29,78.91],[68.76,79.39],[68.18,79.82],[67.56,80.19],[66.91,80.50],[66.23,80.74],[65.53,80.92],[64.82,81.03],[64.10,81.06],[63.38,81.03],[62.66,80.92],[61.96,80.74],[61.28,80.50],[60.63,80.19],[60.01,79.82],[59.43,79.39],[58.90,78.91],[58.42,78.37],[57.99,77.79],[57.62,77.18],[57.31,76.52],[57.06,75.84],[56.89,75.14],[56.78,74.43],[56.75,73.71],[56.78,72.99],[56.89,72.28],[57.06,71.58],[57.31,70.90],[57.62,70.25],[57.99,69.63],[58.42,69.05],[58.90,68.51],[59.43,68.03],[60.01,67.60],[60.63,67.23],[61.28,66.92],[61.96,66.68],[62.66,66.50],[63.38,66.40],[64.10,66.36],[64.82,66.40],[65.53,66.50],[66.23,66.68],[66.91,66.92],[67.56,67.23],[68.18,67.60],[68.76,68.03],[69.29,68.51],[69.78,69.05],[70.21,69.63],[70.58,70.25],[70.89,70.90],[71.13,71.58],[71.31,72.28],[71.41,72.99],[71.45,73.71],[71.41,74.43],[71.31,75.14],[71.13,75.84]], paths=[[0, 1, 2, 3, 4, 5, 6, 7, 8, 9, 10, 11, 12, 13, 14, 15, 16, 17, 18, 19, 20, 21, 22, 23, 24, 25, 26, 27, 28, 29, 30, 31, 32, 33, 34, 35, 36, 37, 38, 39, 40, 41, 42, 43, 44, 45, 46, 47, 48, 49, 50, 51, 52, 53, 54, 55, 56, 57, 58, 59, 60, 61, 62, 63], [64, 65, 66, 67, 68, 69, 70, 71, 72, 73, 74, 75, 76, 77, 78, 79, 80, 81, 82, 83, 84, 85, 86, 87, 88, 89, 90, 91, 92, 93, 94, 95, 96, 97, 98, 99, 100, 101, 102, 103, 104, 105, 106, 107, 108, 109, 110, 111, 112, 113, 114, 115, 116, 117, 118, 119, 120, 121, 122, 123, 124, 125, 126, 127]]);
  polygon(points=[[76.52,97.08],[77.79,96.93],[78.90,95.90],[79.75,95.20],[77.84,95.61],[76.39,95.79],[74.95,95.83],[73.51,95.75],[68.00,94.93],[65.20,94.68],[62.15,94.66],[59.15,94.88],[57.10,95.16],[55.02,95.58],[52.47,96.30],[53.79,96.14],[55.25,96.10],[56.34,96.17],[57.77,96.38],[59.26,96.17],[62.21,95.96],[65.16,95.98],[67.87,96.23],[73.40,97.04],[74.96,97.13]], paths=[[0, 1, 2, 3, 4, 5, 6, 7, 8, 9, 10, 11, 12, 13, 14, 15, 16, 17, 18, 19, 20, 21, 22, 23, 24]]);
  polygon(points=[[75.01,100.24],[76.11,98.77],[74.89,98.95],[73.48,98.95],[72.07,98.76],[66.61,97.27],[63.81,96.75],[62.21,96.61],[60.46,96.57],[58.87,96.64],[60.57,97.23],[61.98,97.90],[63.61,98.04],[66.30,98.53],[71.77,100.03],[73.45,100.25]], paths=[[0, 1, 2, 3, 4, 5, 6, 7, 8, 9, 10, 11, 12, 13, 14, 15]]);
  polygon(points=[[72.89,104.03],[73.52,102.73],[73.20,102.75],[72.06,102.66],[70.67,102.27],[69.48,101.73],[65.89,99.87],[64.43,99.29],[63.87,99.12],[65.12,100.19],[65.89,100.98],[66.44,101.62],[68.92,102.91],[70.26,103.51],[71.89,103.96]], paths=[[0, 1, 2, 3, 4, 5, 6, 7, 8, 9, 10, 11, 12, 13, 14]]);
  polygon(points=[[70.13,108.11],[69.38,107.73],[69.64,109.32],[69.84,109.38],[71.26,109.58],[71.51,108.26],[71.22,108.28]], paths=[[0, 1, 2, 3, 4, 5, 6]]);
  polygon(points=[[60.96,108.25],[60.50,107.39],[59.81,106.48],[58.98,105.71],[58.16,105.16],[57.28,104.74],[56.18,104.43],[55.05,104.30],[54.07,104.35],[52.95,104.59],[52.04,104.94],[51.06,105.51],[50.30,106.13],[49.54,106.99],[49.02,107.81],[48.62,108.71],[48.36,109.68],[49.54,110.67],[49.67,109.78],[49.89,109.02],[50.23,108.31],[50.75,107.56],[51.29,106.98],[51.91,106.50],[52.72,106.06],[53.46,105.79],[54.10,105.66],[54.75,105.60],[55.28,105.61],[55.93,105.70],[56.56,105.87],[57.17,106.11],[57.75,106.43],[58.28,106.81],[58.76,107.26],[59.18,107.76],[59.54,108.31],[59.83,108.90],[60.04,109.52],[60.18,110.16],[60.23,110.82],[60.21,111.47],[60.07,112.25],[59.78,113.12],[59.41,113.81],[58.94,114.44],[58.38,115.00],[57.64,115.54],[56.93,115.89],[56.09,116.16],[57.27,117.16],[57.88,116.89],[58.44,116.57],[58.98,116.19],[59.47,115.77],[59.92,115.29],[60.32,114.78],[60.75,114.08],[61.03,113.49],[61.25,112.88],[61.41,112.25],[61.52,111.44],[61.53,110.79],[61.49,110.14],[61.37,109.49],[61.20,108.86]], paths=[[0, 1, 2, 3, 4, 5, 6, 7, 8, 9, 10, 11, 12, 13, 14, 15, 16, 17, 18, 19, 20, 21, 22, 23, 24, 25, 26, 27, 28, 29, 30, 31, 32, 33, 34, 35, 36, 37, 38, 39, 40, 41, 42, 43, 44, 45, 46, 47, 48, 49, 50, 51, 52, 53, 54, 55, 56, 57, 58, 59, 60, 61, 62, 63, 64, 65]]);
  polygon(points=[[55.66,110.31],[55.36,110.07],[54.98,109.95],[54.59,109.99],[54.25,110.18],[54.00,110.48],[53.89,110.85],[53.93,111.24],[54.11,111.58],[54.41,111.83],[54.79,111.94],[55.18,111.91],[55.52,111.72],[55.77,111.42],[55.88,111.05],[55.84,110.66]], paths=[[0, 1, 2, 3, 4, 5, 6, 7, 8, 9, 10, 11, 12, 13, 14, 15]]);
  polygon(points=[[63.71,107.04],[63.04,105.79],[62.19,104.65],[61.19,103.64],[60.05,102.80],[58.80,102.13],[57.46,101.65],[56.07,101.37],[54.65,101.30],[53.24,101.44],[51.86,101.79],[50.55,102.33],[49.33,103.06],[48.23,103.96],[47.28,105.01],[46.49,106.19],[46.16,106.82],[45.85,107.57],[46.91,108.46],[47.34,107.38],[47.83,106.48],[48.56,105.50],[49.28,104.76],[50.08,104.12],[50.95,103.59],[52.07,103.09],[53.06,102.80],[53.86,102.66],[54.89,102.60],[55.91,102.66],[56.71,102.80],[57.70,103.09],[58.46,103.40],[59.35,103.89],[60.18,104.49],[60.93,105.19],[61.47,105.81],[62.05,106.66],[62.52,107.57],[62.88,108.53],[63.07,109.32],[63.19,110.13],[63.23,111.15],[63.11,112.38],[62.88,113.37],[62.43,114.52],[61.94,115.42],[61.21,116.40],[60.49,117.14],[59.69,117.78],[58.72,118.37],[59.78,119.26],[60.44,118.84],[61.19,118.26],[61.71,117.77],[62.34,117.07],[62.91,116.31],[63.28,115.71],[63.71,114.86],[64.05,113.98],[64.30,113.06],[64.46,112.13],[64.52,111.42],[64.52,110.48],[64.46,109.77],[64.30,108.83],[64.05,107.92]], paths=[[0, 1, 2, 3, 4, 5, 6, 7, 8, 9, 10, 11, 12, 13, 14, 15, 16, 17, 18, 19, 20, 21, 22, 23, 24, 25, 26, 27, 28, 29, 30, 31, 32, 33, 34, 35, 36, 37, 38, 39, 40, 41, 42, 43, 44, 45, 46, 47, 48, 49, 50, 51, 52, 53, 54, 55, 56, 57, 58, 59, 60, 61, 62, 63, 64, 65, 66]]);
  polygon(points=[[58.26,109.55],[57.92,108.92],[57.47,108.37],[56.91,107.91],[56.28,107.58],[55.60,107.37],[54.89,107.30],[54.17,107.37],[53.49,107.58],[52.86,107.91],[52.30,108.37],[51.85,108.92],[51.51,109.55],[51.31,110.24],[51.24,110.95],[51.31,111.66],[51.50,112.31],[54.13,114.52],[54.71,114.59],[55.24,114.58],[55.77,114.49],[56.28,114.32],[56.91,113.98],[57.47,113.53],[57.92,112.98],[58.26,112.35],[58.47,111.66],[58.54,110.95],[58.47,110.24],[57.06,111.85],[56.84,112.25],[56.55,112.61],[56.19,112.90],[55.78,113.12],[55.34,113.25],[54.89,113.30],[54.43,113.25],[53.99,113.12],[53.58,112.90],[53.22,112.61],[52.93,112.25],[52.71,111.85],[52.58,111.41],[52.54,110.95],[52.58,110.49],[52.71,110.05],[52.93,109.64],[53.22,109.29],[53.58,109.00],[53.99,108.78],[54.43,108.64],[54.89,108.60],[55.34,108.64],[55.78,108.78],[56.19,109.00],[56.55,109.29],[56.84,109.64],[57.06,110.05],[57.19,110.49],[57.24,110.95],[57.19,111.41]], paths=[[0, 1, 2, 3, 4, 5, 6, 7, 8, 9, 10, 11, 12, 13, 14, 15, 16, 17, 18, 19, 20, 21, 22, 23, 24, 25, 26, 27, 28], [29, 30, 31, 32, 33, 34, 35, 36, 37, 38, 39, 40, 41, 42, 43, 44, 45, 46, 47, 48, 49, 50, 51, 52, 53, 54, 55, 56, 57, 58, 59, 60]]);
  polygon(points=[[66.69,106.40],[66.32,105.54],[65.89,104.71],[65.40,103.92],[64.86,103.17],[64.26,102.45],[63.61,101.79],[62.91,101.17],[62.17,100.61],[61.39,100.10],[60.57,99.65],[59.73,99.26],[58.85,98.94],[57.96,98.68],[57.05,98.49],[56.13,98.36],[55.20,98.30],[54.26,98.31],[53.34,98.39],[52.42,98.54],[51.51,98.76],[50.62,99.04],[49.76,99.38],[48.92,99.79],[48.12,100.26],[47.35,100.79],[46.62,101.37],[45.94,102.00],[45.31,102.69],[44.72,103.41],[44.20,104.18],[43.44,105.55],[44.48,106.42],[45.15,105.11],[45.94,103.97],[46.86,102.92],[47.90,102.00],[49.05,101.21],[50.29,100.57],[51.59,100.09],[52.94,99.77],[54.05,99.63],[55.44,99.61],[56.55,99.72],[57.64,99.94],[58.97,100.36],[59.99,100.81],[61.19,101.51],[62.09,102.18],[62.91,102.92],[63.83,103.97],[64.47,104.88],[65.15,106.10],[65.57,107.13],[65.96,108.46],[66.18,109.84],[66.24,110.95],[66.15,112.34],[65.90,113.71],[65.47,115.03],[64.89,116.30],[64.16,117.48],[63.29,118.57],[62.30,119.54],[61.15,120.41],[62.19,121.28],[63.15,120.53],[63.83,119.89],[64.46,119.21],[65.23,118.23],[65.89,117.18],[66.32,116.36],[66.69,115.50],[66.99,114.62],[67.23,113.72],[67.40,112.81],[67.50,111.88],[67.53,110.64],[67.44,109.40],[67.29,108.48],[66.99,107.28]], paths=[[0, 1, 2, 3, 4, 5, 6, 7, 8, 9, 10, 11, 12, 13, 14, 15, 16, 17, 18, 19, 20, 21, 22, 23, 24, 25, 26, 27, 28, 29, 30, 31, 32, 33, 34, 35, 36, 37, 38, 39, 40, 41, 42, 43, 44, 45, 46, 47, 48, 49, 50, 51, 52, 53, 54, 55, 56, 57, 58, 59, 60, 61, 62, 63, 64, 65, 66, 67, 68, 69, 70, 71, 72, 73, 74, 75, 76, 77, 78, 79, 80]]);
  polygon(points=[[68.73,116.32],[68.31,117.30],[67.77,118.32],[69.97,117.13],[71.23,116.63],[71.07,115.29],[69.45,115.94]], paths=[[0, 1, 2, 3, 4, 5, 6]]);
  polygon(points=[[72.25,120.72],[71.85,119.46],[70.54,119.78],[68.20,120.56],[64.97,121.85],[63.92,122.73],[64.67,123.37],[68.67,121.78],[70.87,121.04]], paths=[[0, 1, 2, 3, 4, 5, 6, 7, 8]]);
  polygon(points=[[87.10,142.19],[90.08,141.59],[92.88,140.72],[99.90,138.23],[103.37,137.14],[107.09,136.17],[115.13,134.38],[115.13,133.03],[114.53,133.20],[106.80,134.90],[103.00,135.90],[99.47,137.00],[92.49,139.48],[89.78,140.32],[87.10,140.88],[85.67,140.98]], paths=[[0, 1, 2, 3, 4, 5, 6, 7, 8, 9, 10, 11, 12, 13, 14, 15]]);
  polygon(points=[[89.09,143.85],[91.93,142.93],[98.66,140.34],[100.63,139.71],[102.59,139.19],[106.04,138.52],[111.54,137.85],[113.79,137.50],[115.13,137.19],[115.13,135.86],[113.57,136.22],[111.35,136.56],[105.82,137.24],[102.32,137.91],[100.24,138.47],[98.21,139.12],[91.47,141.71],[89.02,142.53],[87.84,142.80]], paths=[[0, 1, 2, 3, 4, 5, 6, 7, 8, 9, 10, 11, 12, 13, 14, 15, 16, 17, 18]]);
  polygon(points=[[93.13,6.39],[94.20,7.64],[95.23,8.69],[96.53,9.75],[96.87,9.98],[96.83,9.24],[96.85,8.33],[96.13,7.76],[95.17,6.78],[94.68,6.20],[93.08,6.20]], paths=[[0, 1, 2, 3, 4, 5, 6, 7, 8, 9, 10]]);
  polygon(points=[[93.83,15.15],[95.62,15.47],[99.34,15.91],[98.81,15.22],[98.33,14.49],[95.79,14.18],[94.09,13.88],[93.19,13.63],[92.87,14.89]], paths=[[0, 1, 2, 3, 4, 5, 6, 7, 8]]);
  polygon(points=[[101.43,17.84],[100.48,17.10],[99.37,17.16],[96.87,17.43],[93.32,17.93],[91.46,18.28],[90.53,19.78],[93.55,19.21],[97.02,18.72],[99.49,18.45],[102.17,18.32]], paths=[[0, 1, 2, 3, 4, 5, 6, 7, 8, 9, 10]]);
  polygon(points=[[96.00,21.19],[97.84,20.71],[99.71,20.36],[101.61,20.15],[103.31,20.08],[106.47,19.76],[105.56,19.62],[104.78,19.43],[104.02,19.19],[103.08,18.80],[101.08,19.01],[98.79,19.41],[96.52,19.95],[88.47,22.21],[87.39,23.17],[86.27,24.02],[88.37,23.59],[93.18,22.23],[94.80,21.59]], paths=[[0, 1, 2, 3, 4, 5, 6, 7, 8, 9, 10, 11, 12, 13, 14, 15, 16, 17, 18]]);
  polygon(points=[[87.11,25.95],[88.07,25.19],[86.08,25.68],[84.41,25.87],[82.83,25.84],[81.20,26.39],[79.84,26.70],[80.61,26.87],[82.61,27.13],[84.51,27.17],[85.89,27.01]], paths=[[0, 1, 2, 3, 4, 5, 6, 7, 8, 9, 10]]);
  polygon(points=[[79.99,32.59],[78.82,31.82],[75.34,29.18],[74.63,28.77],[75.36,29.54],[76.02,30.38],[76.59,31.28],[77.00,32.07],[78.09,32.90],[79.34,33.71],[80.48,34.19],[81.10,33.04]], paths=[[0, 1, 2, 3, 4, 5, 6, 7, 8, 9, 10, 11]]);
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
