rei-okabayashi/denshi-tools/(list of files, cad)

Other CAD files:
3d/ag03-stand/ag03_stand_ext_p4.stl
3d/ag03-stand/ag03_stand_half_a.stl
3d/ag03-stand/viewer/stl/p_half_b.stl
3d/ag03-stand/ag03_stand_ext_p2.stl
3d/ag03-stand/viewer/stl/a_ext_p3.stl
3d/ag03-stand/ag03_stand_ext_p1.stl
3d/ag03-stand/viewer/stl/a_ag_drawer.stl
3d/ag03-stand/viewer/stl/a_ag_b.stl
3d/ag03-stand/viewer/stl/p_half_a.stl
3d/ag03-stand/viewer/stl/p_ext_p2.stl
3d/ag03-stand/viewer/stl/p_ext_p1.stl
3d/ag03-stand/viewer/stl/p_ext_p3.stl
3d/ag03-stand/viewer/stl/p_drawer.stl
3d/ag03-stand/viewer/stl/p_panel_a.stl
3d/ag03-stand/viewer/stl/a_panel_r.stl
3d/ag03-stand/viewer/stl/a_panel_l.stl
