rei-okabayashi/denshi-tools/3d/ag03-stand/preview_print_bed.png

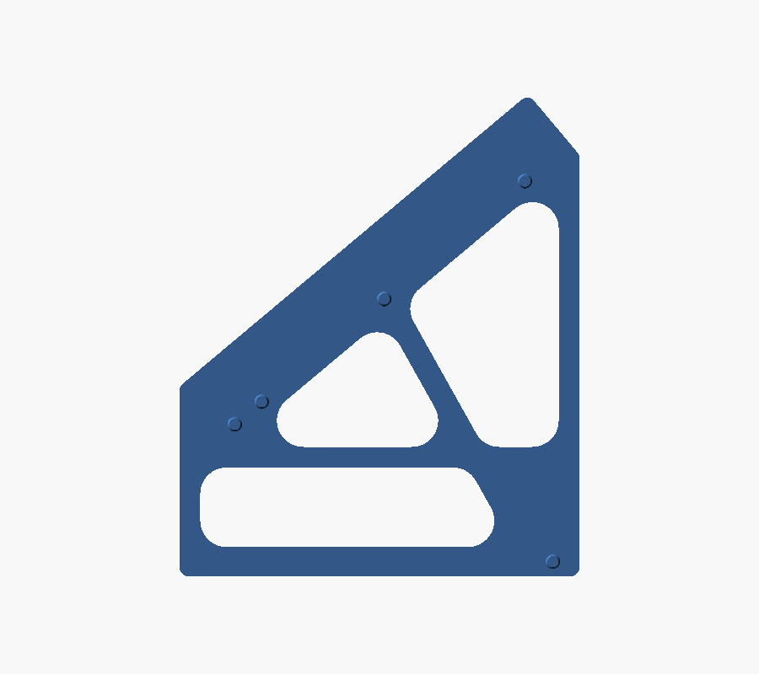
3d/ag03-stand/preview_print_bed.png
