rei-okabayashi/denshi-tools/(commit log)

2026-07-25 logic-lab v1.2: キーボードだけで回路を組めるように＋監査34件是正(起動不能バグ/WCAG AA/つまみ直しのちらつき)
    6レンズ多角監査(反証検証つき)で27件、変更差分の再レビューで5件、実機検証で2件を確定し全件対応。
    検証: Playwright実操作E2E 45項目 + 非タッチ環境6項目 + html_audit.py(ERROR/WARN/INFO 0) + __selfTest全PASS。
    ■ 壊れる系
    - 壊れた/改変されたlocalStorageで起動不能になる経路を封鎖(実機で再現→修正)。validCircuitで
    wire.idの型と重複・入力ポート番号の範囲・1入力1本・出力を持たないノード起点・NaN/Infinity座標・
    ループ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
2026-07-25 fe-kamoku-b.html新設: 科目B反復トレーニング80問(擬似言語66+セキュリティ14)
    - 本試験形式の選択式ドリル。誤答は同セッション内で再出題、2回連続正解で「定着」
    - 分野別フィルタ/弱点だけ/未挑戦だけモード+習熟マップ+キーボード操作(1-5/Enter)
    - 全80問を機械検証済み(擬似言語はPython翻訳実行×2段+手動41チェック、secは反証レビュー)
    - 導線: index.htmlカード/fe-guideのCTA/fe-cram復習リンク/fe-algoのpager接続
    - E2E 34項目+html_audit ERROR/WARN/INFO 0件
2026-07-25 fe-kamoku-b初心者対応: 解き方ガイド(タイプ別4ステップ+実演デモ3種+記号早見表)+全80問に2段階ヒント(着眼点→組み立て)
    - 学習者が「どこから手を付けるか」で詰まらないよう、トレース/穴埋め/セキュリティの
    タイプ別に「型」を明文化し、1手ずつ進む実演デモ(トレース表が埋まる/代入法/消去法)を新設
    - 全80問に解答前の2段階ヒント(h1着眼点/h2組み立て)を追加。Opus5の執筆8+反証検証8で
    生成し答えバレ8件を検証段で修正、統合はJSONパースで機械検証済み
    - 出題カードに型別4ステップ常設、キーボードHでヒント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
2026-07-26 fe-kamoku-b-jissen新設: 科目B実践演習(本試験形式の生成型12問)
    - IPA公開問題50問の実測調査に準拠した外形(定型句・擬似言語記法・解答群の作法・型名下線)
    - 全問がシード生成型: 数値・変種・正答・誤答をテンプレート内シミュレータが計算(暗記不能)
    - スマホトレース道具: コード固定表示+行マーカー+トレース表+専用キーパッド(iOS readonly対策)
    - 別シード2回正解=攻略の記録、2段階ヒント、経過タイマー
    - 品質: 全12問を独立再実装300〜5000シードでクロスチェック、位置バレ・誤答モデル縮退・
    生成例外(20万シードス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
2026-07-27 fe-kamoku-b-jissen 監査反映: 12→15問(諸分野/ビット演算/セキュリティC型)＋解説の追跡性是正
    62エージェント監査(所見を1件ずつ反証検証)の確定所見を修正し、カバレッジの穴を埋めた。
    解説の追跡性
    - jb06 参照の付け替え prev.next ← prev.next.next を具体値で追う行を追加(末尾削除で未定義に
    なる件・空欄aのif判定も明示)。監査の学習者シミュレーションで唯一詰まった箇所
    - jb03 「(残りも同じ理由の組合せです)」の打ち切りを廃止。18.3%のシードで事実に反していた
    - jb02 aもbも外れた組合せ(毎回2〜4個)を全件説明。領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
2026-08-06 AI/テンプレ痕跡の調査を反映: 視覚未確認の崩れ26件を修正＋機械検出を新設
    「AI生成っぽさを消す手法」を6角度から調査し(98主張/35URLを反証検証)、
    このサイトに実害があるものだけを採用した。有名な視覚系tell(紫グラデ・Inter・
    gradient text・装飾glassmorphism・全角大文字ラベル)は元から0件で、代わりに
    機械監査を素通りしていた実バグが出てきたのでそれを直した。
    実バグ(html_audit.py は ERROR/WARN/INFO 0 で通っていた):
    - index.html の全カード10件 … .t/.d が両方 display:inline で
    タイトルと説明が同じ行に潰れていた(margin-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
2026-08-08 科目B実践演習にjb16を追加(16問)＋暗記耐性の是正4件＋色付きカードのAA違反を修正
    jb16(配列の配列を探索する繰返し処理の制御)を新設。サイト全体で0件だった4記法
    —— 整数型配列の配列 / 論理型 / 繰返し処理を終了する / // α ラベル —— を1問に
    同居させ、4つとも解く上で意味を持つ設計にした(フラグが戻り値を分岐させ、
    ラベル付き脱出か内側だけの脱出かで正解が変わる)。
    暗記耐性の是正(いずれも実測→修正→再実測):
    - jb02 正解の(a,b)が3組→5組。「最頻の組を選ぶ」41.8%→19.5%(乱択14.4%)
    - jb03 正解の内容が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
2026-08-08 問題一覧の見出しに残っていた「擬似言語11問」を12問に是正
    dad2626 で16問へ増やしたとき、title/description/OG/lead/使い方は直したが、
    画面に見えている h2「問題一覧 — 擬似言語11問＋セキュリティ4問」とその直下の
    「擬似言語11：セキュリティ4の比率は…」を取りこぼしていた（公開後に本番URLを
    取得して発覚）。可変の数値を固定文に焼き込んでいる典型で、
    lesson-fixed-copy-data-drift に記録済みの罠を再度踏んだもの。
    比率の説明文も、11:4→12:4 で「本試験の16：4に合わせています」が事実と
    ずれるため、「16：4に寄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
2026-08-09 GitHubアカウント改名(nerunerunerure-hue→rei-okabayashi)に伴い公開HTML22ページ内のURLを一斉更新
2026-10-18 YouTube 投稿ツール用のプライバシーポリシー privacy.html を追加
    Google の OAuth 同意画面を本番にするには、公開されたプライバシーポリシーの URL が要る。
    個人用の動画投稿ツール（紙の地球儀 投稿ツール）が扱う情報と、保存・共有・取り消し方法を書いた1ページ。
    .gitignore の許可リストに privacy.html を追加。publish_check.py 合格（ERROR 0 / WARN 0）。
2026-11-02 AG03/AG03MK2用 40°チルトスタンド(ネジ・接着剤・サポート不要)の3Dデータを追加
    - OpenSCADのパラメトリック設計 + 印刷用STL(左右2分割、圧入ダボで結合)
    - 圧入クリアランス確認用のテスト片
    - 3d/ を公開対象に追加
    Claude-Session: https://claude.ai/code/session_01BMznTnTpze8Ho1qE6Frkjr
2026-11-02 スタンドの既定寸法を初代AG03(129×63×202mm)に変更してSTLを再出力
    - model の既定値を AG03 に変更(MK2は切替で引き続き出力可)
    - half_a / half_b のSTLとプレビュー画像を再生成
    - READMEの寸法表記を初代基準に更新
    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
2026-11-03 手前ストッパーの高さを8mm→27.0mmに変更してSTLを再出力
    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
2026-11-03 初代AG03の幅を実測値128.8mmに変更してSTLを再出力
    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
2026-11-03 手前ストッパー下を前脚として埋め、前倒れを防止
    ストッパー先端から机まで垂直に落とした面で左右の角を埋める。
    前面中央はヘッドセットプラグの通り道として空けたまま。
    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
2026-11-03 初代AG03の坂形の側面形状(手前28.0mm・奥54.3mm)を設計に反映
    - 本体寸法に手前/奥の高さを追加し、組立プレビューを坂形に変更
    - ストッパー・側板が本体の手前の高さを超えないことをassertで確認
    - READMEの全高・重心・形状の説明を更新(印刷用STLの形状は変更なし)
    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
2026-11-03 スタンドの外観を曲線主体のデザインに刷新
    接地面・本体との接触面だけを平面に残し、それ以外を曲線化。
    - 前脚の前面・後脚の背面をえぐったアーチ形、底面中央をアーチにして前後の脚で接地
    - 肉抜き穴をR9の丸三角形に拡大、外形・横桁の角を丸め
    - 側板上辺をストッパーから滑らかに下げ、後端を丸める
    - 横桁の付け根にR6のフィレット(サポート不要)
    - 側面フレームとストッパーの幅を14mmに統一、ダボを5mmに変更し肉厚を検査
    Claude-Session: https://claude.ai/code/session_01BMz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
2026-11-03 スタンドの外形をシンプルに戻す(内側へのえぐり・アーチ・フィレットを廃止)
    - 平らな底・垂直な前面/背面・傾斜面だけの外形にし、凸の角だけR3で丸める
    - 肉抜き穴はR9の丸三角形を維持
    - 側板は一定高さの帯にして後端をフレームと揃える
    - ダボ径を peg_d にまとめ、圧入テスト片も5mmに合わせて再出力
    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
2026-11-03 AG03の下の空間に手前へ引き出せる引き出しを追加
    - 本体手前下端を35→55mmに上げ、引き出しの通り道を確保
    - 手前下の横桁を廃止し、手前上の横桁にダボを2本配置
    - 引き出し(外寸123×101×42mm)は左右フレーム内面にガイドされ机上を滑る。レール・ネジ不要
    - 前面上辺に半円の指掛け。引き出し量0〜全開で土台と干渉しないことを確認
    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
2026-11-03 ダボ穴のクリアランスをテスト片の結果(0.10mmがぴったり)に合わせて変更
    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
2026-11-03 引き出しの指掛け穴をやめ、前板につまみを追加
    - 前板中央に幅40×出っ張り9mmのつまみ(下面45°でサポート不要)
    - 閉めたとき前板が前脚の前面と面一になる位置を維持
    - つまみを支えるため前板を2.4mmに
    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
2026-11-03 引き出しの上を天井板でふさぎ、閉めたとき中が見えないように変更
    - 台に厚さ3mmの天井板(前脚の前面〜背面まで全長)を追加
    - 側面フレームに天井の高さの横材を入れ、肉抜き穴を下段の長穴＋上段の三角2つに再構成
    - 引き出しの高さを天井板の下に合わせて42→40mmに
    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
2026-11-03 前面を一直線の斜面でつなぎ、底面と背面を板でふさぐ
    - 天井板の前端からAG03の手前下端まで斜面で埋め、前から見た段差・すき間をなくす
    - 机に接する底面に床板、AG03の後ろに隠れる背面に背板(各2.4mm)を追加。横の穴はそのまま
    - 引き出しは床板の上を滑るように高さを40→38mmに
    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
2026-11-03 左右の手前ストッパーを全幅の前板でつなぐ
    初代AG03は前面のこの範囲に端子がないため、高さ27mmの前板で左右をつなぎ、
    前脚・引き出しの前面と面一の平らな正面にした。AG03・引き出しとの干渉なしを確認。
    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
2026-11-03 手前ストッパー(前板)と側板の高さを17mmにそろえる
    AG03は全体が曲面仕上げで、底から17mmが一番幅のある部分のため、
    前板・側板ともこの高さで受ける。引き出しは前面位置の変化に合わせて奥行を短縮。
    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
2026-11-03 見直し結果を反映：ダボ強化・床板の相欠き・引き出しの面取りと抜け止め・薄板の厚み増し
    - ダボを直径5→6mm、5→8か所に(前板の下部に2本追加し、前の下側の開きを防止)
    - 床板の継ぎ目を相欠き(重ね継ぎ)にして左右の段差・開きを防止
    - 引き出しの底の外周を0.4mm面取り(象の足でこすれないように)
    - 引き出しの左右にツメ式の抜け止め。側面の下段の穴の前縁に当たり約82mmで止まる
    - 床板・背板を2.4→3mmに。READMEにブリム・最小レイヤー時間などの印刷注意を追記し、記載の乱れを修正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
2026-11-03 引き出しを改良：見えない抜け止めと一体型の取っ手
    - 側面から見えていたツメ式の抜け止めをやめ、底の溝＋床板の小さな山(パーツA)による
    ソフトストップに変更。約84mmで止まり、強めに引けば外せる
    - つまみを前板上端の全幅の「ひさし」型取っ手に変更(上面は縁と面一、下面45°)
    - 溝を入れるため引き出しの底を1.6→2.4mmに
    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
2026-11-03 側面の化粧パネルのデザイン案(4種)を追加
    台の肉抜き穴に裏のリムを差し込んで留める化粧パネル。表面に彫った模様は
    0.4mmでフィラメントを替えると2色になる。panel_style で eq / wave / grille / lines / plain を切替。
    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
2026-11-03 側面パネルに古代遺跡ファンタジー風のデザイン案3種を追加
    古代テック回路(relic)・ルーンの円環(rune)・石板の渦紋(stone)。
    特定作品のロゴや紋章は使わないオリジナル模様。比較シートの縦横比も修正。
    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
2026-11-03 側面パネルに参考画像の「波紋」模様を追加し、既定にする
    大小の同心円を散らし、すき間を円をよけて流れる波線で埋める模様。
    tools/gen_ripple.py(numpy/shapely/contourpy)で生成した ripple_pattern.scad を use する。
    左右パネルのSTLとプレビュー、READMEの説明を追加。
    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
2026-11-03 誤って追加した __pycache__ を削除し、無視リストに追加
    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
2026-11-04 波紋模様を参考画像の描画ルールに沿って作り直す
    参考画像を分析し、下の層から順に描いて上の円で隠すルールにした：
    ①同じ形の波線を一定間隔で全面に → ②大きな同心円 → ③中・小の同心円を下の円の縁にかぶせる。
    線の太さ・間隔は共通、上の円の外側には線間と同じすき間。円どうしの重なりを許容。
    表を金・線を黒にしたプレビューと、参考画像との比較画像を追加。
    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
2026-11-04 側面パネルを黒1色で印刷する前提に変更
    2色前提の説明をやめ、溝の陰影とツヤの差で模様を見せる設計に。
    陰影が出るよう彫りを0.8→1.0mmに深くし、プレビューを黒1色で描画。
    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
2026-11-05 Kindle Paperwhite(第10世代・横置き)とM5Stack Basicを並べる増設台を追加
    AG03台と同じ側面形状・前の線・穴の共通規格で、AG03台の右に連結キーでつなぐ。
    - 機器の前面を前板の上端にそろえる(Kindleは座面を8.8mm持ち上げ)
    - KindleとM5Stackの間にL字プラグ前提のケーブルの通り道。背面と底面後方を開口
    - 引き出しを後から付けられる空間(天井・床・仕切り・奥の壁・抜け止めの山)
    - 4分割(どれもサポート不要)、分割面はダボ。切り口の厚み0の面を避けて閉じた形状を確認
    Claude-Session: h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
2026-11-05 ケーブルの通り道に差し込み式のカバーを追加し、ケーブルを見えなくする
    - 通り道の奥に受け台を追加し、手前・奥の受け台に溝を彫る(P3のみ変更)
    - カバーは溝に差し込むだけで外せる。L字アダプタの厚みを逃がす高さに設定
    - カバーと台・機器が干渉しないことを確認
    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
2026-11-05 ケーブルカバーの上面を前板の上端と面一にする
    受け台にカバーの厚み分の段を彫ってはめ込み、カバー裏の中央を0.8mmくぼませてL字アダプタを逃がす。
    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
2026-11-05 全体見直し：通り道パーツの薄膜を除去し、ケーブルカバーの留まりと剛性を改善
    - カバーをはめる段の加工範囲を通り道より広げ、P3の両面に残っていた厚さ0.008mmの膜をなくす
    - カバー差し込み部のすき間を0.2→0.10mm(ダボと同じ締まり具合)に
    - カバー裏の中央にたわみ止めのリブを追加
    - 全STLが最新コードと一致・閉じた形状・1つの塊であること、印刷向きのオーバーハングを数値で確認
    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
2026-11-05 増設台：机の穴へ通す床の穴を追加し、奥の下を梁にして強度アップ
    - M5Stackの下の引き出し空間の床に穴(前後45〜90mm)。机の穴からのケーブルを正面の口から引き出せる
    - 通り道の下の天井に穴を開け、Kindle・M5Stackのケーブルを下段→床の穴へ通す
    - 背面・床の後ろを閉じ、奥の下を全幅の梁にして分割面ごとにダボ2本を追加
    - M5Stackの座面とパーツAの床の舌で生じていた非多様体の辺を解消(パーツBは据え置きで互換)
    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
2026-11-05 STLを回して見られる3Dビューア(viewer/index.html)を追加
    - 組み立て表示(分解・色分け・部品ごとの表示切替・クリックで寸法)と、印刷用STLをA1 miniのベッド上に表示
    - three.js(r147)をCDNから読み込み、STLはviewer/stl/のバイナリSTLを読む
    - tools/export_viewer.sh で組み立て位置の部品と印刷用STLを書き出し、tools/stl_to_binary.py でバイナリ化
    - OpenSCADに組み立て位置の書き出し用パーツ(va_*)を追加
    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
2026-11-05 増設台：Kindle・M5Stackの上側の空きを埋めて上面を面一に
    - 傾斜の長さが余る機器の上側を前板の上端の高さまで埋め、機器・前板・カバーと同じ平らな面に
    - 機器の上端の中央に取り出し用の指掛け(両端45°でサポート不要)
    - 埋めた部分は側板に1mm重ね、指掛けの底は座面から0.3mm上げて微小な辺を防止
    - ビューア用STLを更新
    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
2026-11-05 AG03台: 強度・印刷の見直し、抜け止め削除、床の穴追加
    - 引き出しの抜け止め（台の山・引き出しの溝）を削除し、引き出しの底を 1.6mm に戻す
    - 増設台 P3: カバーの差し込み溝の奥に残っていた厚さ 0.4mm の壁を解消（受け台を 2mm 広げる）
    - 増設台の床板を 4mm に（印刷時に高さ 85mm の片持ちの壁になるため）
    - 床の穴を Kindle の下にも追加。M5Stack 側とも上から見た形を 45° 面取りの八角形にし、
    印刷時の穴の上辺の橋渡しを 17mm 程度に抑える
    - STL・ビューア用 STL・README を更新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
2026-11-05 AG03台: 引き出しの上のデッドスペースを補強の箱に
    - 天井板を上へ 7mm 厚くして 10mm に（引き出しの高さは変更なし）。印刷で下になる端は 45° より急な斜面で立ち上げてサポート不要
    - 傾斜面の下に全幅の板（4mm、AG03 から 1mm 逃がす）と、側面フレームの斜材と同じ線の斜めの仕切り（5mm）を追加し、閉じた三角の箱にする
    - 補強は左右フレームの内側だけに入れ、側面の穴・パネルのリム・連結キーには影響させない
    - 左右の継ぎ目と増設台 P1｜P2 に、厚い天井板のダボを 2 本ずつ追加
    - 増設台の Kindle 側・M5Stack 側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
2026-11-06 AG03台: 天井板より上の背板を厚く、引き出しの奥を梁に
    - 天井板より上の背板を 3mm → 6.5mm（側面フレームの後ろの柱とそろえる。穴にはかからない）
    - 引き出しの奥（止め〜背面、床〜天井）を増設台と同じ太い梁にし、ダボを 1 本追加。
    フレームの下の穴にかぶさる端は 45° より急な斜面で広げてサポート不要
    - 増設台の Kindle 側・M5Stack 側も背板を同じく厚く
    - STL・ビューア用 STL・README を更新
    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
2026-11-06 AG03台: モジュール化（部品ごとの刷り直し・拡張モジュールの自動生成）
    - AG03 台の継ぎ目のダボを、印刷済みの初版パーツA の 8 本（pegs_v1）と補強で増えた 3 本（pegs_v2）に分けて固定。
    パーツB（右）だけ刷り直しても初版の A と組める
    - 刷り直す部品（パーツB・増設台 P4）の床の裏に版を刻印（AG03-R v2 / M5 v2）
    - 機器を置くベイの座面・上側の埋めを、機器の厚みと長さだけで決まる共通部品にした（Kindle・M5Stack の形は変更なし）。
    M5Stack を別機種に替えても P3 との継ぎ目と右端の枠は同じ
    - 拡張モジュールの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
2026-11-06 AG03台: 版の刻印をやめる（印刷の乱れを避ける）
    - パーツB・増設台 P4・拡張モジュールの床の裏の刻印を削除
    - 版は printed.md の台帳だけで管理する
    - README・printed.md・ビューア用 STL を更新
    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
2026-11-06 増設台: M5Stack の上のデッドスペースを、フタ付きの隠し収納にする
    - P4 の M5Stack の上側の埋めをくり抜き、小物入れにする（口 約 68×48mm、深さ 14.6mm）
    - 上面と面一のフタ（ext_lid、厚さ 2.4mm）を段に落とし込む。手前の縁を M5Stack の指掛けにかけ、同じ指掛けで持ち上げる
    - 印刷で上になる左端は、段とフタの縁を斜めにし、底へ下りる斜面にしてサポート不要に
    - 収納の底は M5Stack の座面の板。下の補強の箱・P3 との継ぎ目はそのまま（compat_check で初版の P3・カバーと組めることを確認）
    - ビューアにフタを追加し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
